bhadkamkar9snehil/Sofpad/_to_delete/r3_straight/render_rear_ports.png

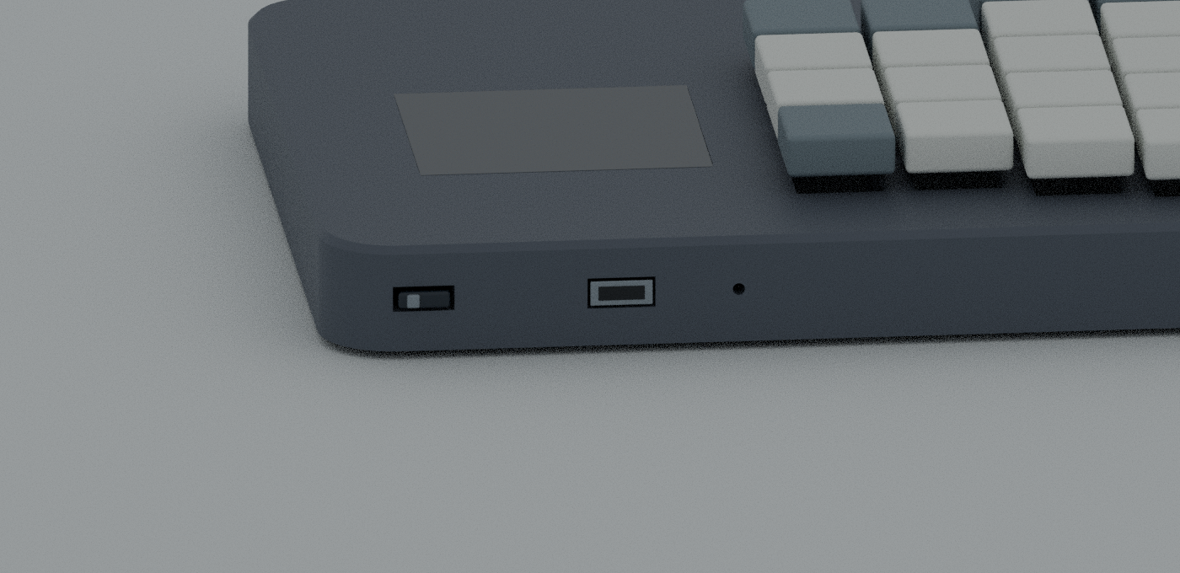
_to_delete/r3_straight/render_rear_ports.png
