bhadkamkar9snehil/Sofpad/_to_delete/r3_straight/render_service.png

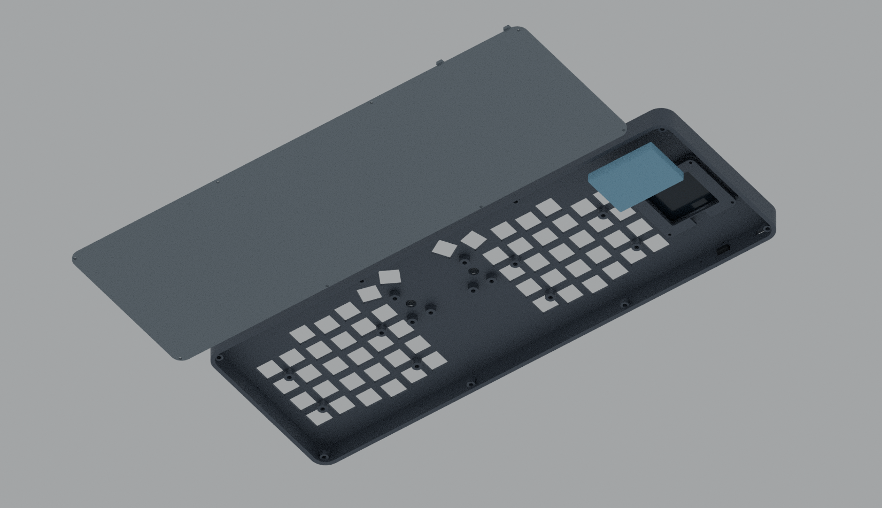
_to_delete/r3_straight/render_service.png
