bhadkamkar9snehil/Sofpad/_to_delete/sofle_couch/CAD_layout.png

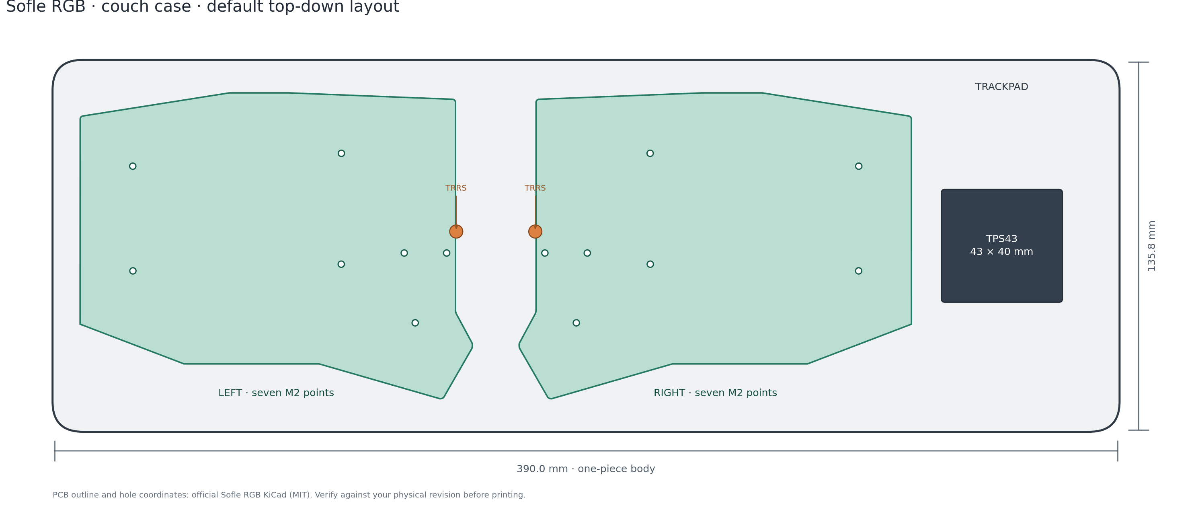
_to_delete/sofle_couch/CAD_layout.png
