bhadkamkar9snehil/Sofpad/_to_delete/sofle_unibody_v2/render_hero.png

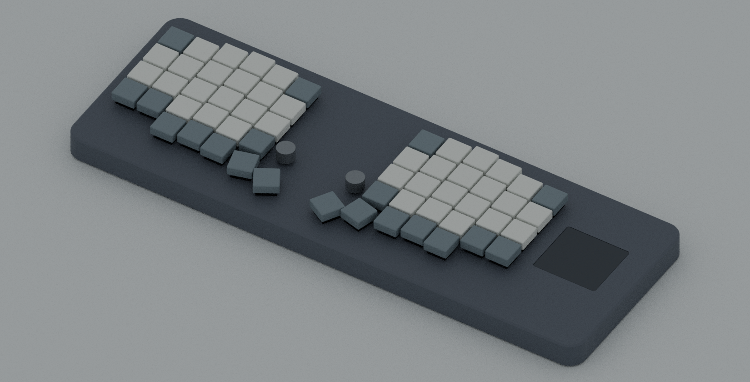
_to_delete/sofle_unibody_v2/render_hero.png
