bhadkamkar9snehil/Sofpad/_to_delete/sofle_unibody_v2/render_top.png

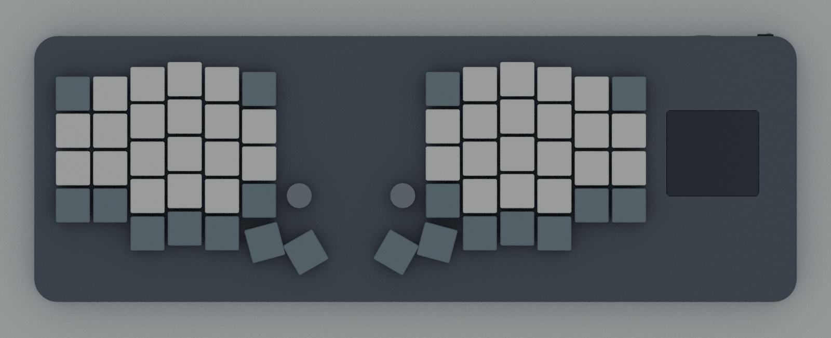
_to_delete/sofle_unibody_v2/render_top.png
