bhadkamkar9snehil/Sofpad/docs/images/sofpad-r2-gallery.webp

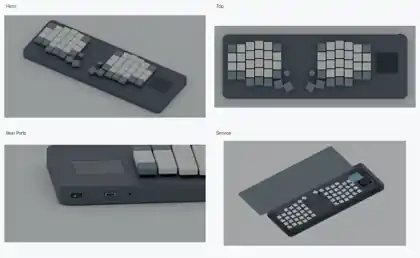
docs/images/sofpad-r2-gallery.webp
