bhadkamkar9snehil/Sofpad/docs/images/sofpad-r3-bay.png

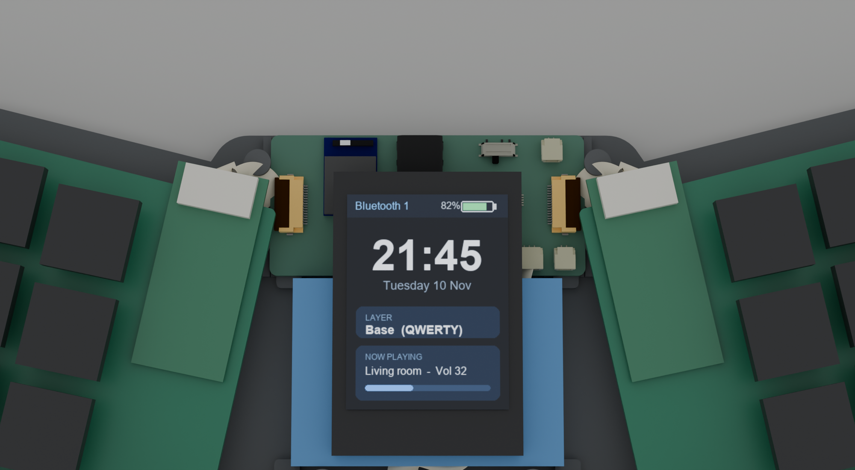
docs/images/sofpad-r3-bay.png
