bhadkamkar9snehil/Sofpad/docs/images/sofpad-r3-ghost.png

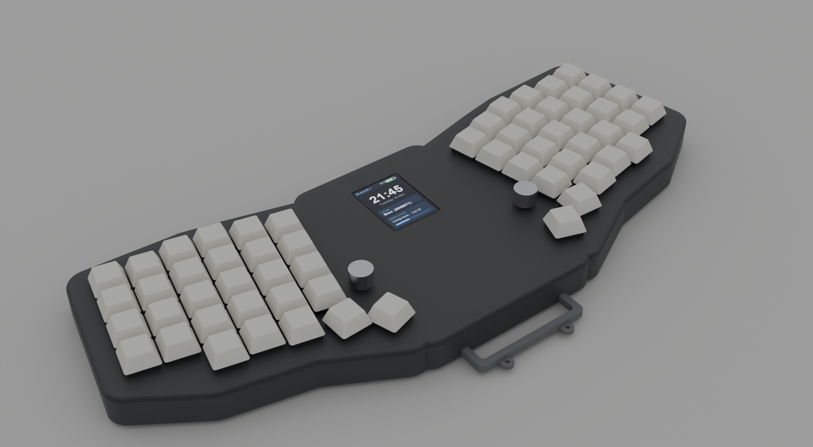
docs/images/sofpad-r3-ghost.png
