bhadkamkar9snehil/Sofpad/docs/images/sofpad-r3-internals-3q.png

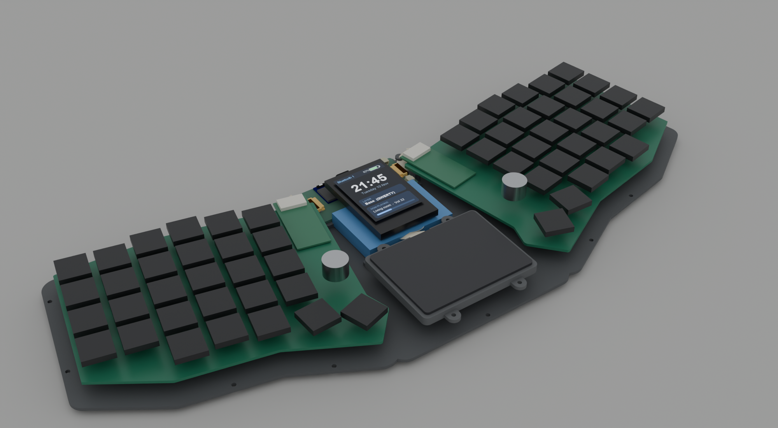
docs/images/sofpad-r3-internals-3q.png
