bhadkamkar9snehil/Sofpad/hardware/r3/pcb/carrier/bottom.png

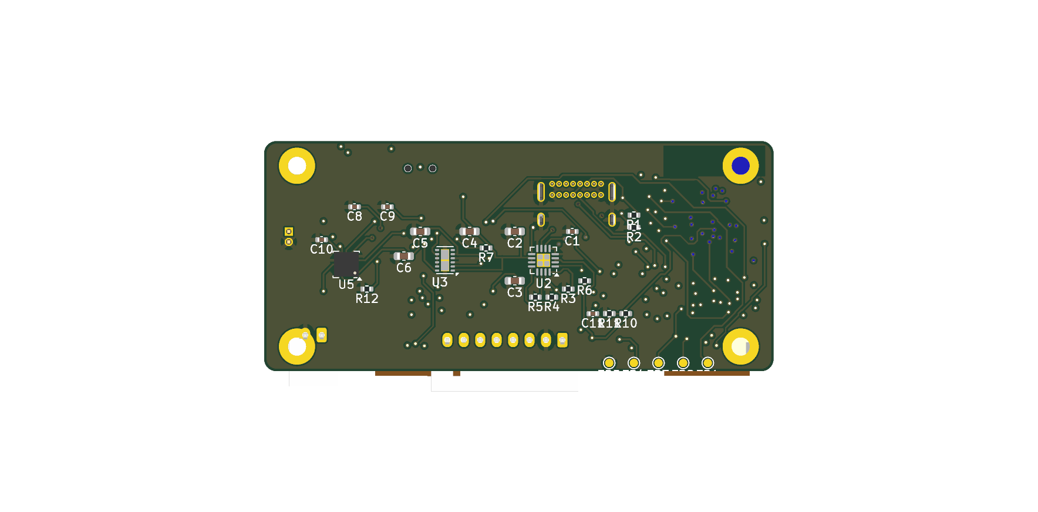
hardware/r3/pcb/carrier/bottom.png
