bhadkamkar9snehil/Sofpad/hardware/r3/pcb/carrier/top.png

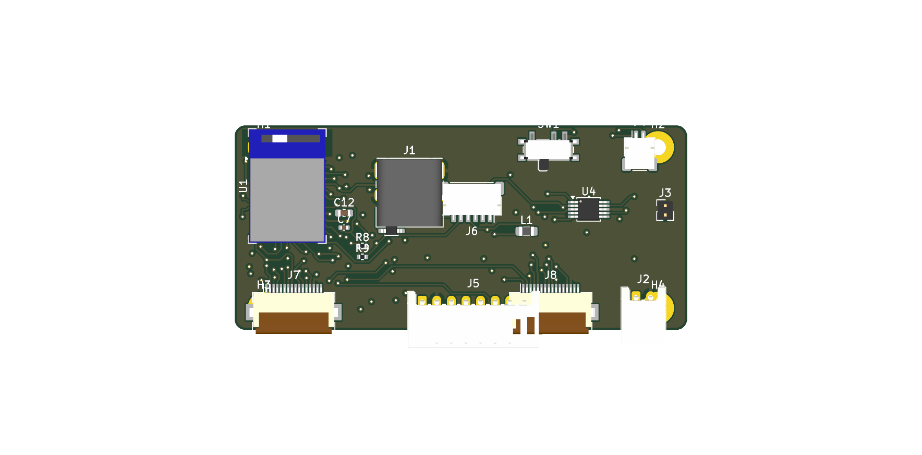
hardware/r3/pcb/carrier/top.png
