bhadkamkar9snehil/Sofpad/hardware/r3/pcb/fab/carrier/carrier-bom.csv

Comment | Designator | Footprint | Quantity
100k | R7 | R_0402_1005Metric | 1
100nF | C10,C11,C7 | C_0402_1005Metric | 3
10k | R12 | R_0402_1005Metric | 1
10uF | C12,C2,C3,C5,C6 | C_0603_1608Metric | 5
1M | R10,R11 | R_0402_1005Metric | 2
1uF | C1,C8,C9 | C_0402_1005Metric | 3
2.0k | R3 | R_0402_1005Metric | 1
2.2uH | L1 | L_0805_2012Metric | 1
3.0k | R6 | R_0402_1005Metric | 1
3.3k | R4 | R_0402_1005Metric | 1
3V3 | TP4 | TestPoint_Pad_D1.0mm | 1
4.7k | R8,R9 | R_0402_1005Metric | 2
4.7uF | C4 | C_0603_1608Metric | 1
470k | R13,R14,R15,R16 | R_0402_1005Metric | 4
47k | R5 | R_0402_1005Metric | 1
5.1k | R1,R2 | R_0402_1005Metric | 2
BQ24074RGTR | U2 | VQFN-16-1EP_3x3mm_P0.5mm_EP1.6x1.6mm | 1
Battery S2B-PH-SM4-TB | J2 | JST_PH_S2B-PH-SM4-TB_1x02-1MP_P2.00mm_Horizontal | 1
C&K PCM12SMTR | SW1 | SW_SPDT_PCM12 | 1
Cell NTC SM02B-SRSS-TB | J3 | JST_SH_SM02B-SRSS-TB_1x02-1MP_P1.00mm_Horizontal | 1
DRV2605LDGSR | U4 | MSOP-10_3x3mm_P0.5mm | 1
GCT USB4085-GF-A | J1 | USB_C_Receptacle_GCT_USB4085 | 1
GND | TP5 | TestPoint_Pad_D1.0mm | 1
LIS3DHTR | U5 | LGA-16_3x3mm_P0.5mm_LayoutBorder3x5y | 1
LRA SM02B-SRSS-TB | J4 | JST_SH_SM02B-SRSS-TB_1x02-1MP_P1.00mm_Horizontal | 1
Left FFC FH12-16S-0.5SH | J7 | Hirose_FH12-16S-0.5SH_1x16-1MP_P0.50mm_Horizontal | 1
MDBT50Q-1MV2 | U1 | Raytac_MDBT50Q | 1
RESET | TP3 | TestPoint_Pad_D1.0mm | 1
Right FFC FH12-16S-0.5SH | J8 | Hirose_FH12-16S-0.5SH_1x16-1MP_P0.50mm_Horizontal | 1
SWDCLK | TP2 | TestPoint_Pad_D1.0mm | 1
SWDIO | TP1 | TestPoint_Pad_D1.0mm | 1
Screen S8B-PH-SM4-TB | J5 | JST_PH_S8B-PH-SM4-TB_1x08-1MP_P2.00mm_Horizontal | 1
TPS62740DSST | U3 | WSON-12-1EP_3x2mm_P0.5mm_EP1x2.65 | 1
TPS65 breakout SM06B-SRSS-TB | J6 | JST_SH_SM06B-SRSS-TB_1x06-1MP_P1.00mm_Horizontal | 1
USBLC6-2SC6 | U6 | SOT-23-6 | 1
