bhadkamkar9snehil/Sofpad/_to_delete/r3_straight/TPS43_Retainer.stl

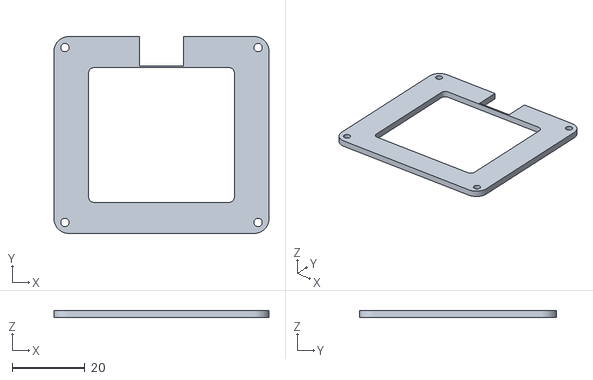
[picture p18: CAD file, 2026-11-09]
_to_delete/r3_straight/TPS43_Retainer.stl
59.0 x 54.0 x 2.00
