bhadkamkar9snehil/Sofpad/_to_delete/sofle_couch/SofleRGB_Couch_Case.stl

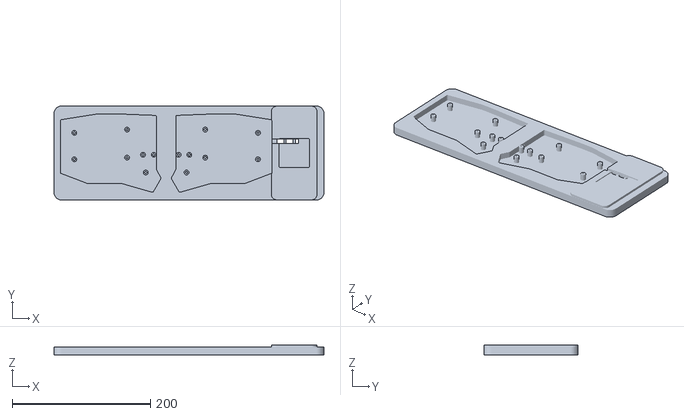
[picture p19: CAD file, 2026-11-09]
_to_delete/sofle_couch/SofleRGB_Couch_Case.stl
390.0 x 135.8 x 15.0
