bhadkamkar9snehil/Sofpad/_to_delete/sofle_unibody_v2/Unibody_Shell.stl

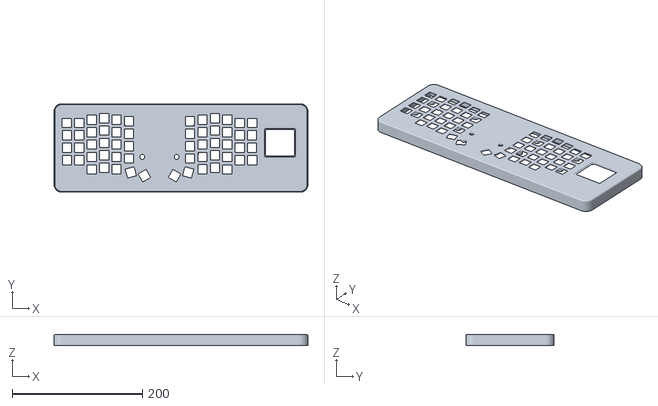
[picture p20: CAD file, 2026-11-09]
_to_delete/sofle_unibody_v2/Unibody_Shell.stl
390.0 x 135.8 x 17.5
