bhadkamkar9snehil/Sofpad/cad/r3/build/bottom.stl

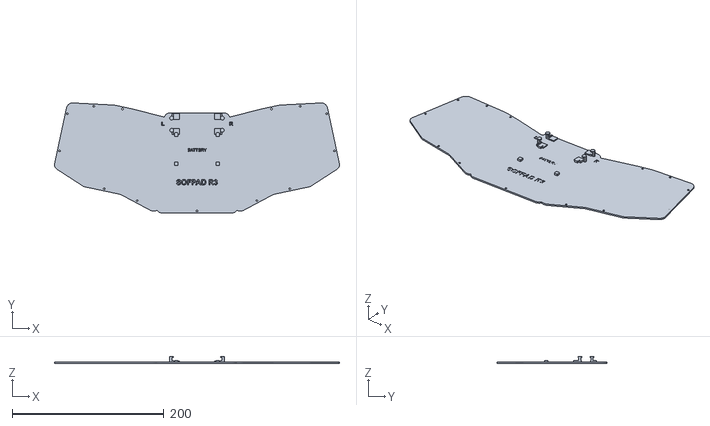
[picture p21: CAD file, 2026-11-09]
cad/r3/build/bottom.stl
375.7 x 145.2 x 9.00
