bhadkamkar9snehil/Sofpad/_to_delete/sofle_couch/TPS43_Fit_Coupon.stl

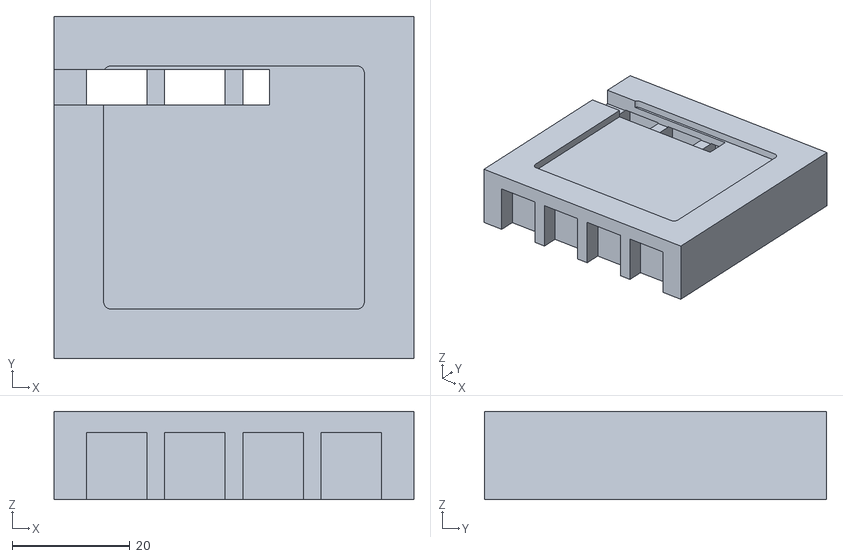
[picture p22: CAD file, 2026-11-09]
_to_delete/sofle_couch/TPS43_Fit_Coupon.stl
61.0 x 58.0 x 15.0
