bhadkamkar9snehil/Sofpad/_to_delete/sofle_unibody_v2/Service_Bottom.stl

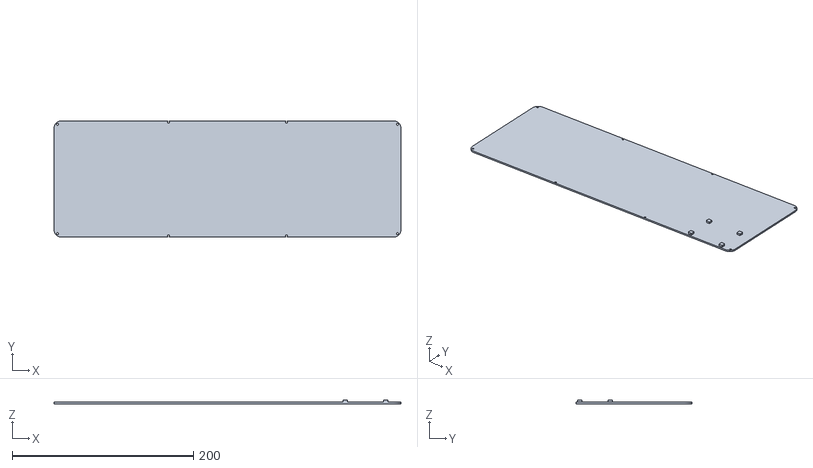
[picture p23: CAD file, 2026-11-09]
_to_delete/sofle_unibody_v2/Service_Bottom.stl
382.5 x 128.3 x 4.00
