bhadkamkar9snehil/Sofpad/cad/r3/build/shell.stl

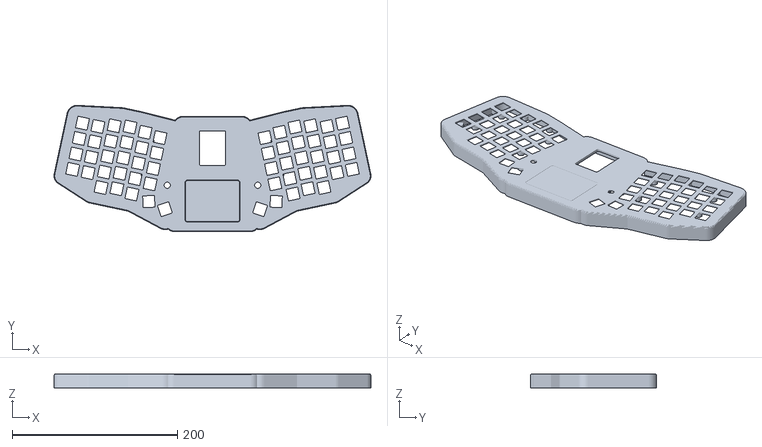
[picture p24: CAD file, 2026-11-09]
cad/r3/build/shell.stl
383.2 x 152.7 x 17.1
