bhadkamkar9snehil/Sofpad/_to_delete/sofle_single_controller_orig/cad/Cirque40_Retainer.stl

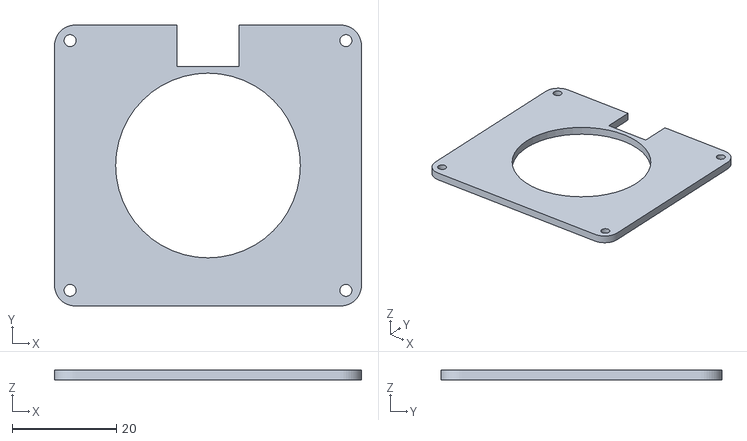
[picture p25: CAD file, 2026-11-09]
_to_delete/sofle_single_controller_orig/cad/Cirque40_Retainer.stl
59.0 x 54.0 x 2.00
