bhadkamkar9snehil/Sofpad/cad/r3/build/padbody.stl

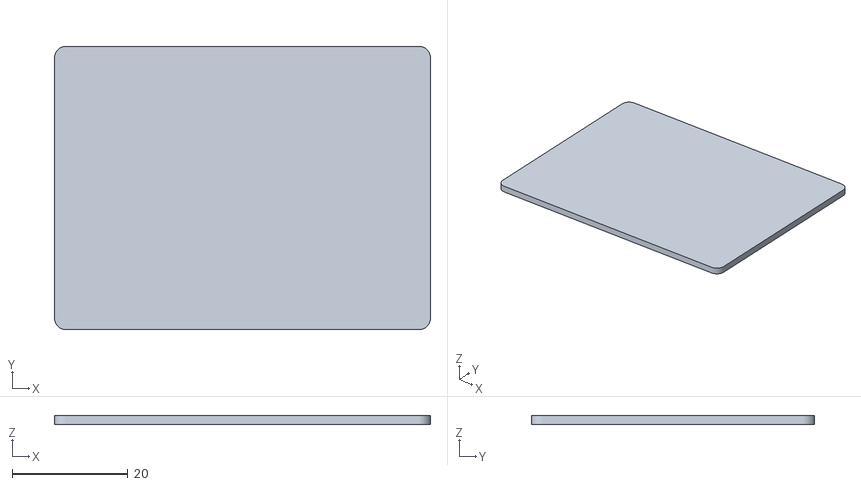
[picture p26: CAD file, 2026-11-09]
cad/r3/build/padbody.stl
65.0 x 49.0 x 1.53
