bhadkamkar9snehil/Sofpad/cad/r3/build/padface.stl

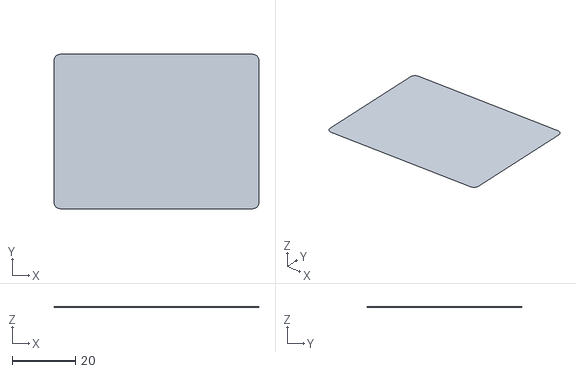
[picture p27: CAD file, 2026-11-09]
cad/r3/build/padface.stl
65.0 x 49.0 x 0.08
