bhadkamkar9snehil/Sofpad/cad/r3/build/adapters.stl

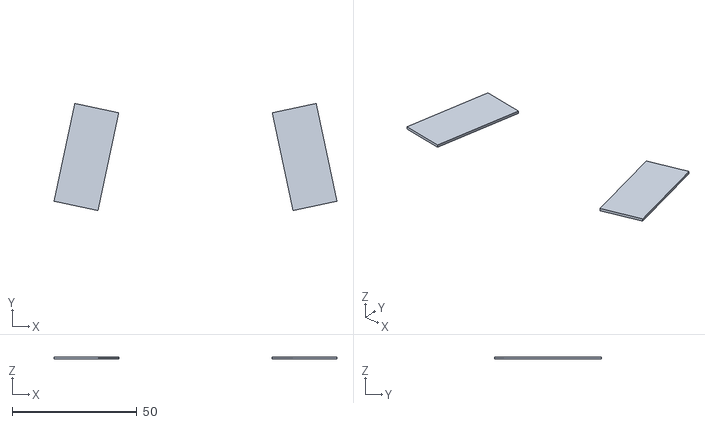
[picture p28: CAD file, 2026-11-09]
cad/r3/build/adapters.stl
113.3 x 42.9 x 1.00
