bhadkamkar9snehil/Sofpad/cad/r3/build/battery.stl

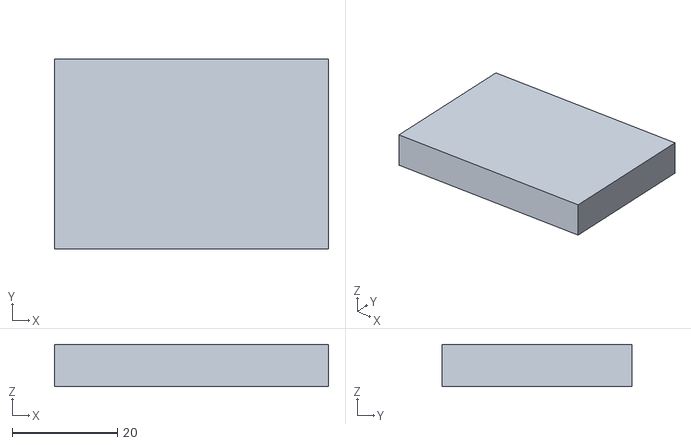
[picture p29: CAD file, 2026-11-09]
cad/r3/build/battery.stl
52.0 x 36.0 x 8.00
