bhadkamkar9snehil/Sofpad/cad/r3/build/carrier.stl

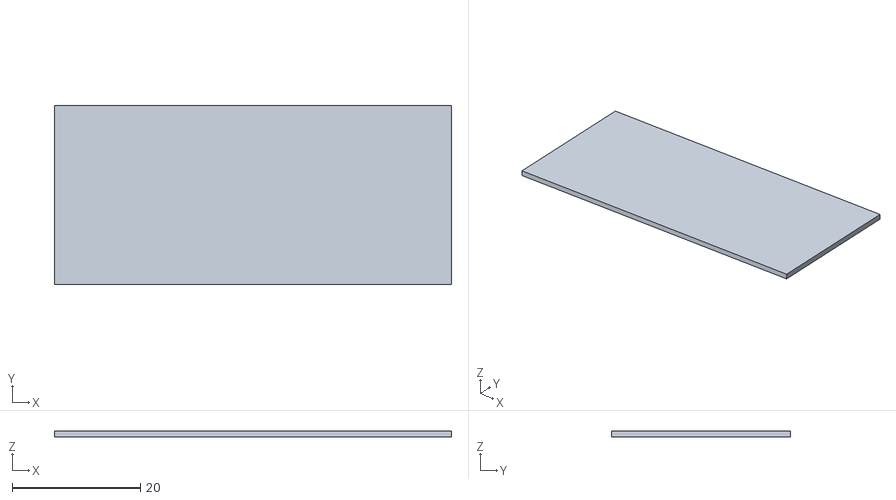
[picture p30: CAD file, 2026-11-09]
cad/r3/build/carrier.stl
62.0 x 28.0 x 1.00
