bhadkamkar9snehil/Sofpad/cad/r3/build/retainer_view.stl

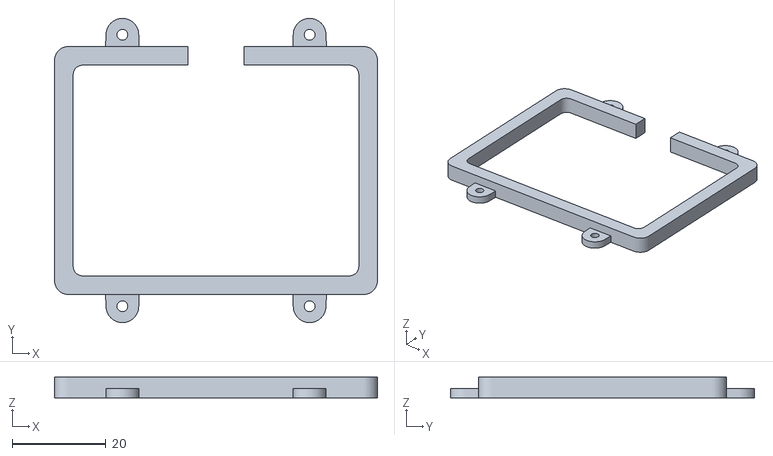
[picture p31: CAD file, 2026-11-09]
cad/r3/build/retainer_view.stl
69.0 x 65.0 x 4.47
