bhadkamkar9snehil/Sofpad/cad/r3/build/adapter_conns.stl

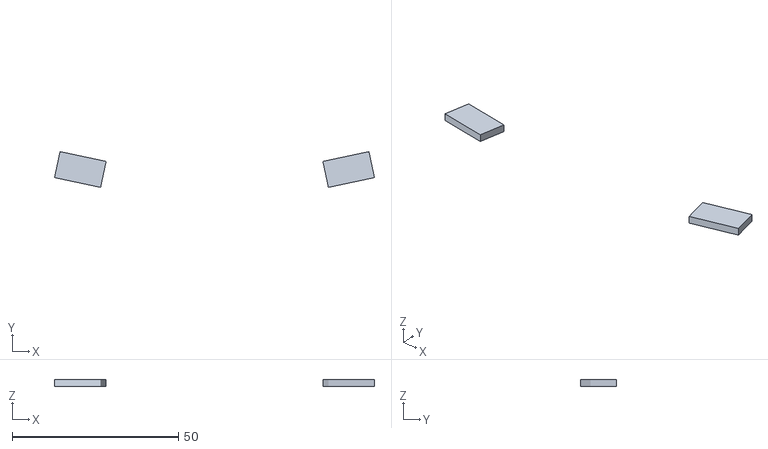
[picture p32: CAD file, 2026-11-09]
cad/r3/build/adapter_conns.stl
96.4 x 10.8 x 2.00
