bhadkamkar9snehil/Sofpad/cad/r3/build/screen.stl

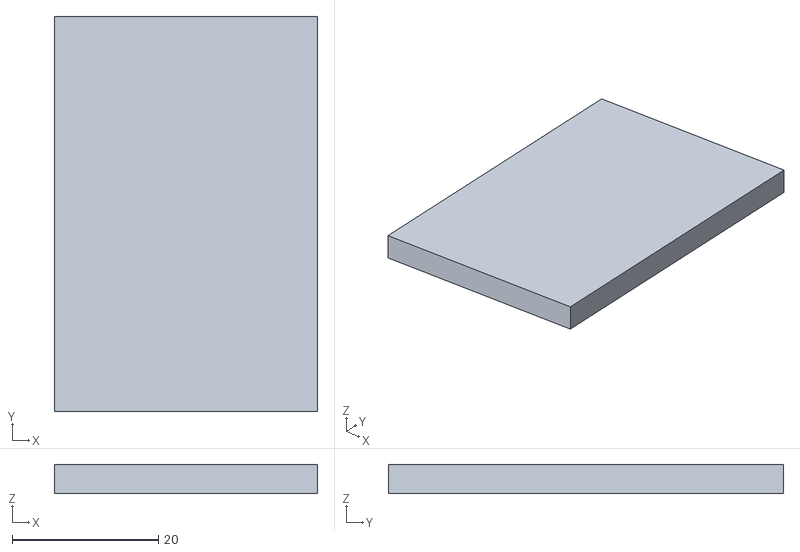
[picture p33: CAD file, 2026-11-09]
cad/r3/build/screen.stl
36.0 x 54.0 x 4.00
