bhadkamkar9snehil/Sofpad/cad/r3/build/keys.stl

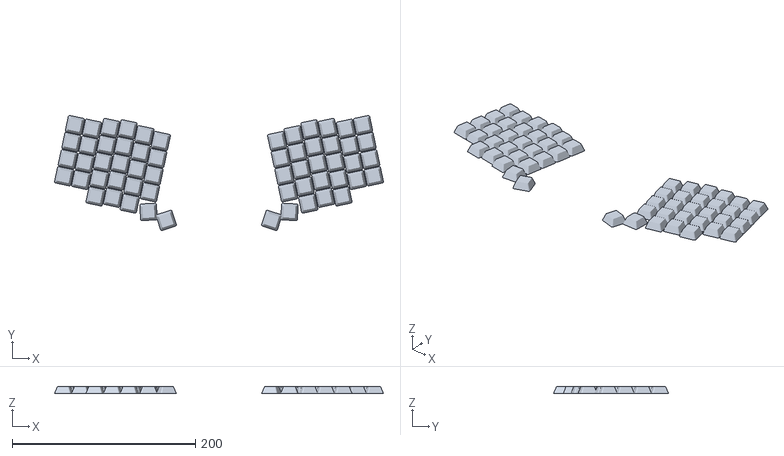
[picture p34: CAD file, 2026-11-09]
cad/r3/build/keys.stl
359.1 x 125.6 x 7.40
