bhadkamkar9snehil/Sofpad/cad/r3/build/knobs.stl

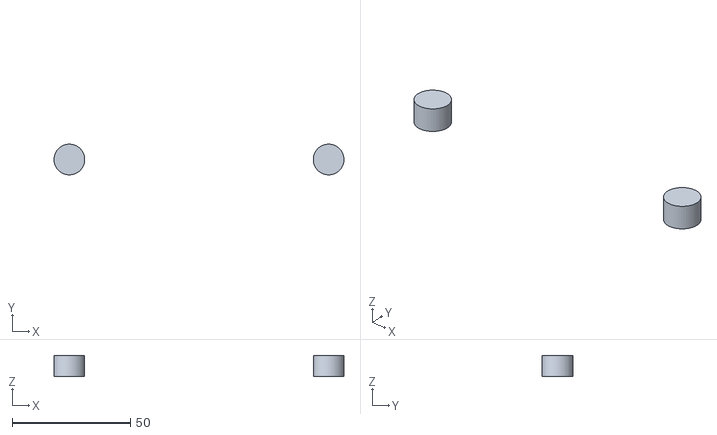
[picture p35: CAD file, 2026-11-09]
cad/r3/build/knobs.stl
122.5 x 13.0 x 9.00
