bhadkamkar9snehil/Sofpad/cad/r3/build/switches.stl

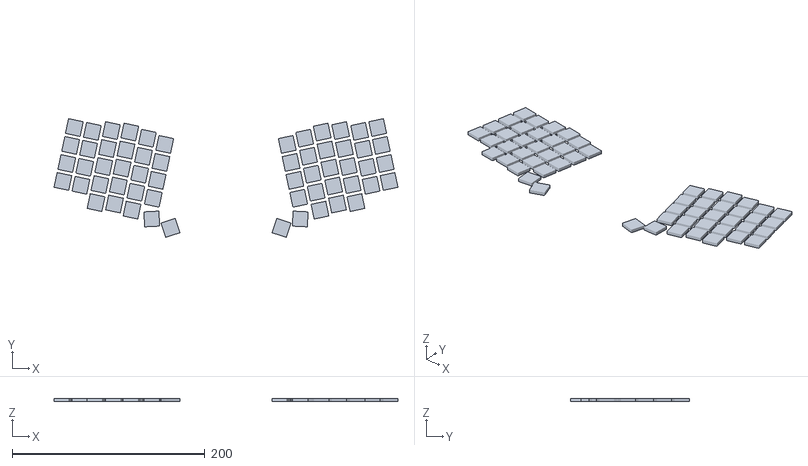
[picture p36: CAD file, 2026-11-09]
cad/r3/build/switches.stl
356.5 x 123.1 x 3.30
