bhadkamkar9snehil/Sofpad/cad/r3/build/pcbs.stl

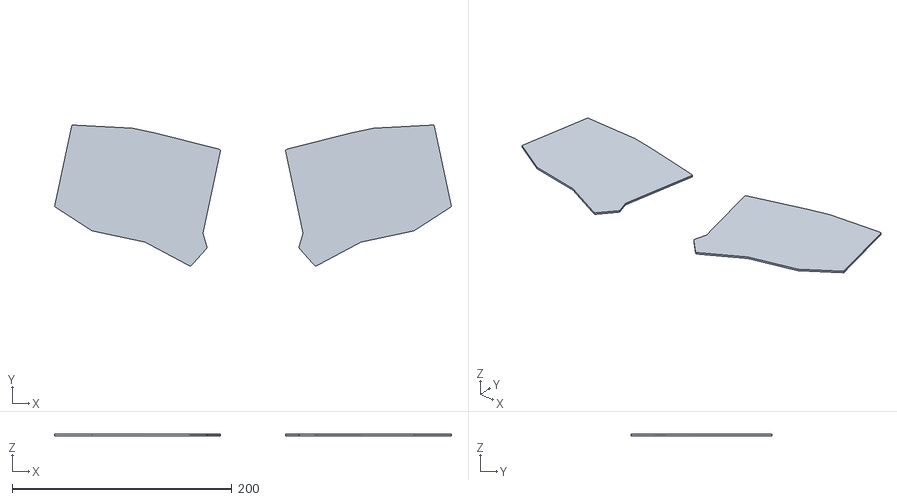
[picture p37: CAD file, 2026-11-09]
cad/r3/build/pcbs.stl
361.2 x 128.2 x 1.60
