bhadkamkar9snehil/Sofpad/_to_delete/sofle_couch/sofle_rgb_geometry.scad

// Generated from Sofle RGB PCB by extract_sofle_geometry.py.
// Source: https://github.com/josefadamcik/SofleKeyboard
// Git commit: fb294f7c58d0f91c379a9ef339159d4d056643e9
// The source project is MIT licensed; see LICENSE-SOFLE.txt.
// Units: mm. Origin: board bounding box, lower-left in the OpenSCAD view.
// The RIGHT half uses this outline. The LEFT half is mirrored in X.

board_w = 143.4952;
board_h = 111.8500;
board_outline = [
    [142.4254, 103.3549],
    [142.6271, 103.3032],
    [142.8119, 103.2185],
    [142.9766, 103.1044],
    [143.1183, 102.9644],
    [143.2339, 102.8022],
    [143.3203, 102.6213],
    [143.3744, 102.4254],
    [143.3932, 102.2181],
    [143.4202, 27.3000],
    [105.4500, 12.8000],
    [56.1041, 12.8000],
    [11.8500, 0.0500],
    [11.3000, 0.1500],
    [10.8500, 0.3000],
    [10.5000, 0.6000],
    [0.2500, 18.4000],
    [0.1000, 18.9000],
    [0.0500, 19.5000],
    [0.0500, 19.9000],
    [0.1500, 20.4000],
    [5.9500, 31.1500],
    [6.1500, 31.7500],
    [6.2253, 32.4000],
    [6.2239, 108.3226],
    [6.2473, 108.5547],
    [6.3144, 108.7710],
    [6.4206, 108.9667],
    [6.5613, 109.1372],
    [6.7318, 109.2778],
    [6.9274, 109.3841],
    [7.1437, 109.4512],
    [7.3759, 109.4746],
    [66.9500, 111.8000],
    [88.9000, 111.8000]
];
board_mount_holes = [
    [9.4500, 53.3000],
    [24.9500, 53.3000],
    [47.9250, 89.7250],
    [124.1750, 85.0250],
    [47.9750, 49.2250],
    [124.1250, 46.7750],
    [20.9500, 27.8000]
];
board_trrs = [5.9500, 61.1500];
