bhadkamkar9snehil/Sofpad/_to_delete/sofle_unibody_v2/sofle_components.scad

// Positions copied from the official Sofle RGB KiCad PCB (MIT).
// x/y are board-local mm. Angle is corrected for a Y-up view.
key_positions = [
    [38.45, 96.8, -180.0],
    [57.45, 99.3, -180.0],
    [76.55, 101.8, -180.0],
    [95.55, 99.3, -180.0],
    [114.65, 94.4, -180.0],
    [133.75, 94.4, -180.0],
    [38.45, 77.7, -180.0],
    [57.45, 80.2, -180.0],
    [76.55, 82.71, -180.0],
    [95.55, 80.3, -180.0],
    [114.65, 75.5, -180.0],
    [133.65, 75.5, -180.0],
    [38.45, 58.7, -180.0],
    [57.45, 61.2, -180.0],
    [76.55, 63.61, -180.0],
    [95.55, 61.2, -180.0],
    [114.65, 56.3, -180.0],
    [133.65, 56.3, -180.0],
    [38.45, 39.7, -180.0],
    [57.45, 42.1, -180.0],
    [76.55, 44.61, -180.0],
    [95.55, 42.1, -180.0],
    [114.65, 37.3, -180.0],
    [133.7, 37.3, -180.0],
    [14.66, 13.4, -120.0],
    [35.55, 18.4, 165.0],
    [57.45, 23.1, -180.0],
    [76.55, 25.51, -180.0],
    [95.55, 23.0, -180.0]
];
encoder_positions = [
    [17.95, 42.3, -0.0]
];
