bhadkamkar9snehil/Sofpad/(list of files, cad)

Other CAD files:
_to_delete/r3_straight/Unibody_Shell.stl
_to_delete/r3_straight/Service_Bottom.stl
_to_delete/sofle_unibody_v2/TPS43_Retainer.stl
cad/r3/build/retainer.stl
_to_delete/sofle_unibody_v2/SofleRGB_Unibody_Couch.scad
_to_delete/sofle_single_controller_orig/cad/Service_Bottom.stl
_to_delete/sofle_single_controller_orig/cad/SofleRGB_SingleController_Cirque.scad
_to_delete/sofle_single_controller_orig/cad/Unibody_Shell.stl
