bhadkamkar9snehil/Sofpad/cad/r3/build/screen_ui.png

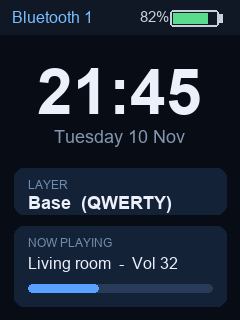
cad/r3/build/screen_ui.png
