bhadkamkar9snehil/Sofpad/(list of files, drawings)

Other design files:
hardware/r3/pcb/adapter/adapter_a.dsn
hardware/r3/pcb/adapter/adapter_b.dsn
hardware/r3/pcb/carrier/carrier.dsn
