bhadkamkar9snehil/Sofpad/hardware/r3/pcb/carrier/carrier.kicad_pcb

## KiCad design hardware/r3/pcb/carrier/carrier.kicad_pcb (2026-11-10)

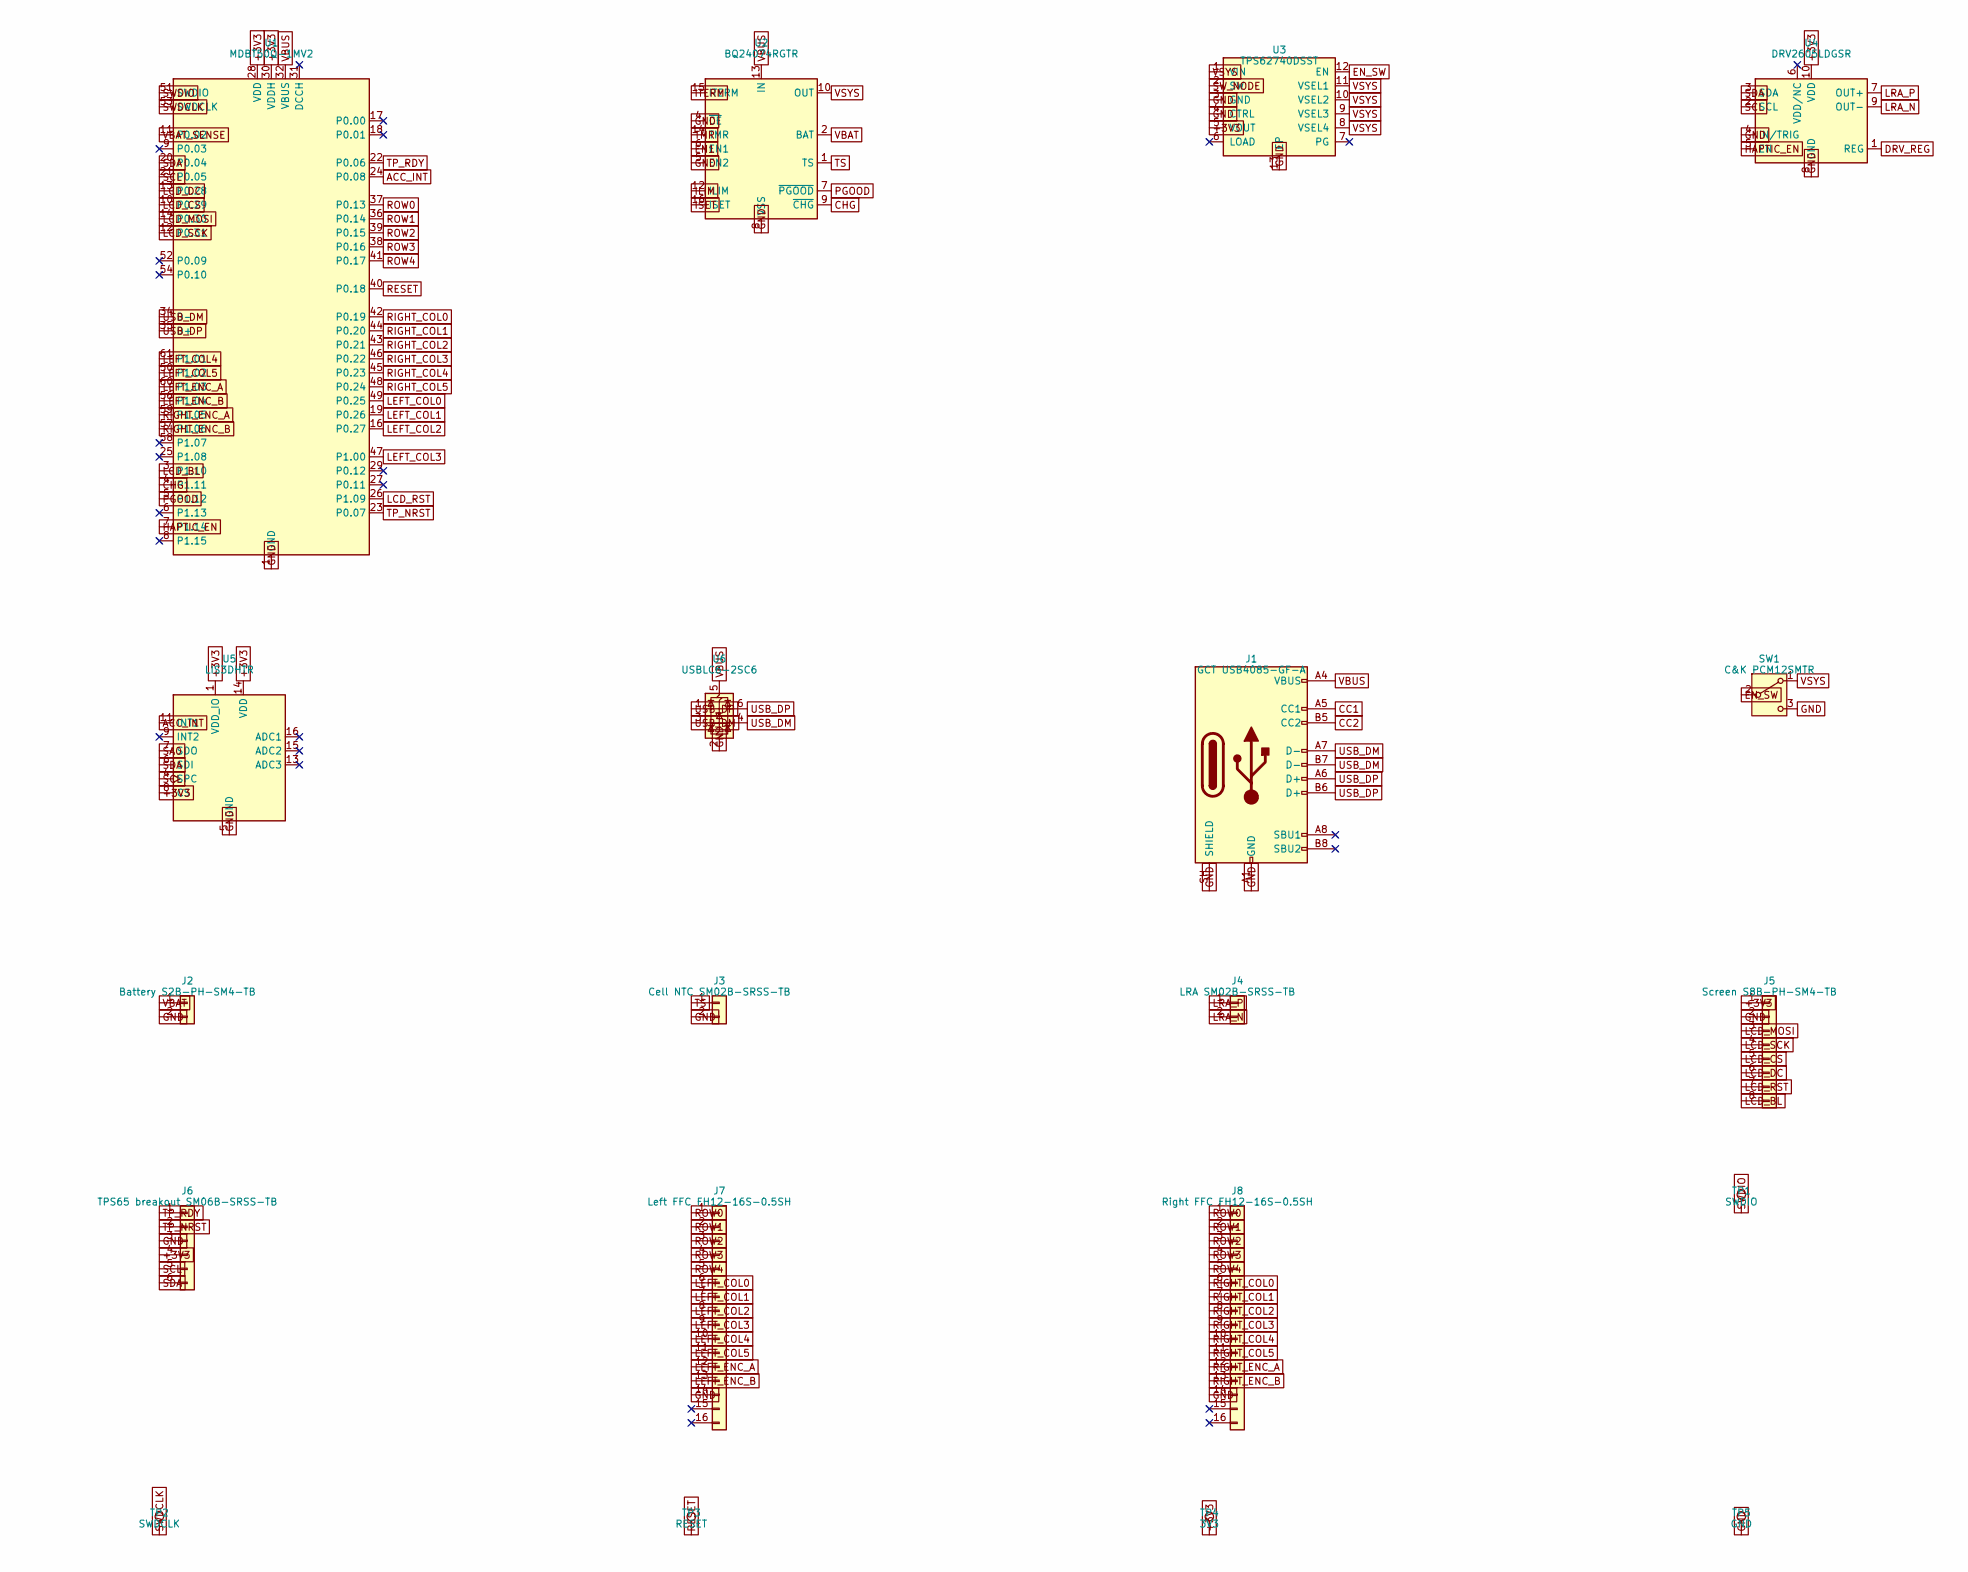
[picture p39: schematic carrier.kicad_sch, part in row 1, column 1]

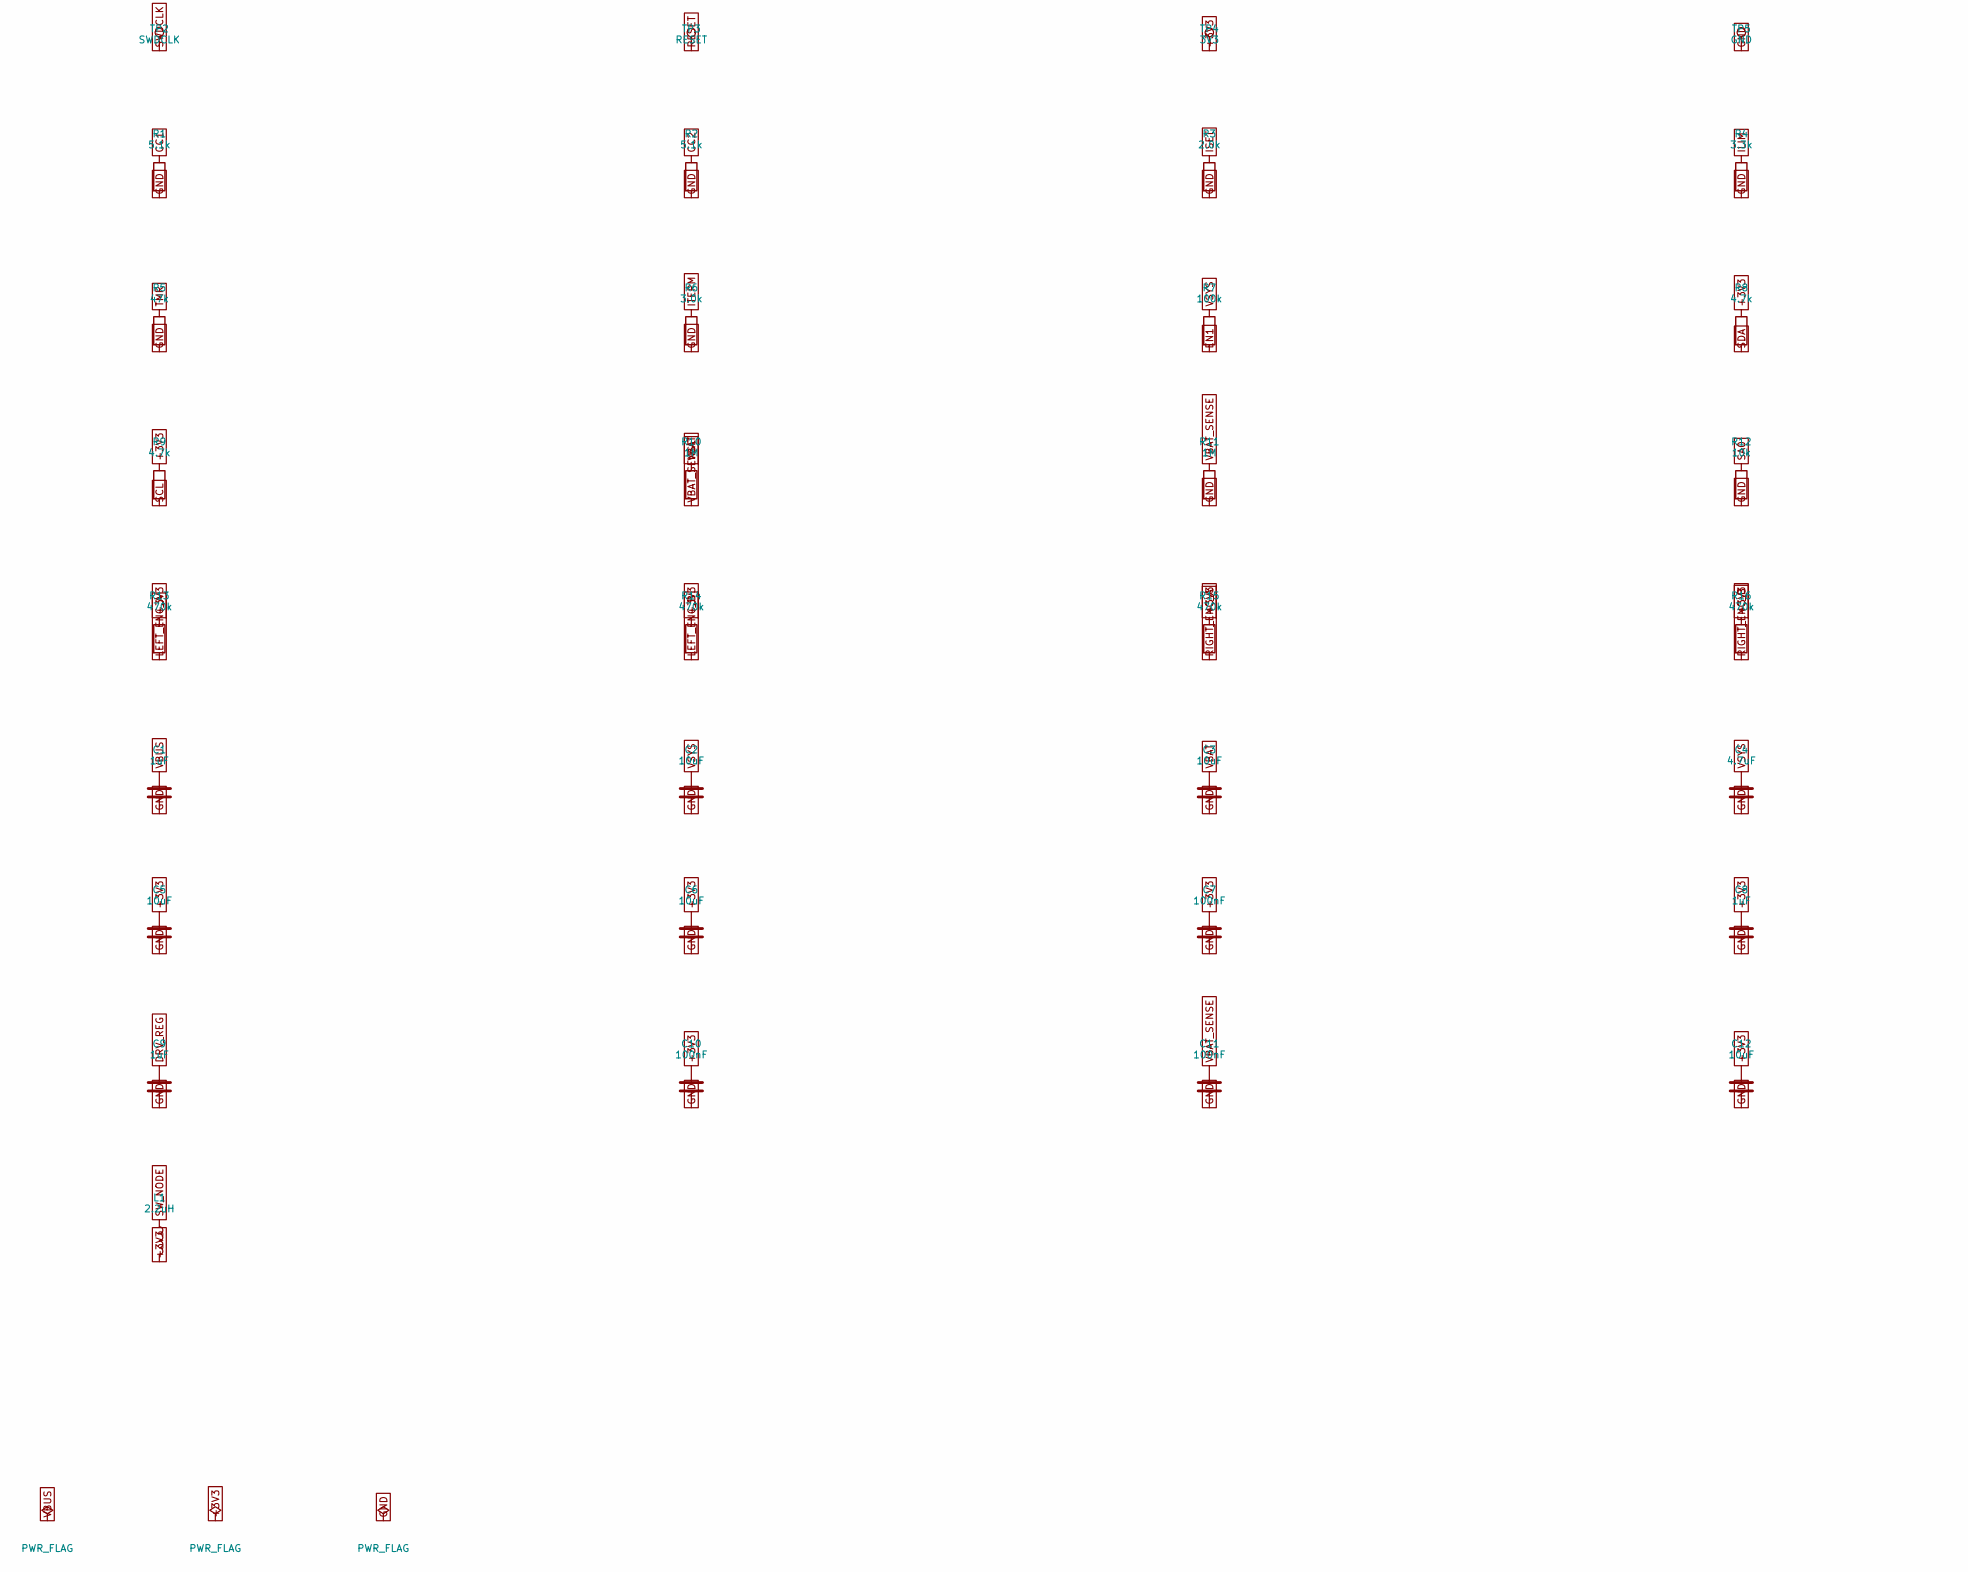
[picture p40: schematic carrier.kicad_sch, part in row 2, column 1]

Parts:
C1, C8, C9: 1uF; C_0402_1005Metric
C2, C3, C5, C6, C12: 10uF; C_0603_1608Metric
C4: 4.7uF; C_0603_1608Metric
C7, C10, C11: 100nF; C_0402_1005Metric
J1: GCT USB4085-GF-A; USB_C_Receptacle_GCT_USB4085
J2: Battery S2B-PH-SM4-TB; JST_PH_S2B-PH-SM4-TB_1x02-1MP_P2.00mm_Horizontal
J3: Cell NTC SM02B-SRSS-TB; JST_SH_SM02B-SRSS-TB_1x02-1MP_P1.00mm_Horizontal
J4: LRA SM02B-SRSS-TB; JST_SH_SM02B-SRSS-TB_1x02-1MP_P1.00mm_Horizontal
J5: Screen S8B-PH-SM4-TB; JST_PH_S8B-PH-SM4-TB_1x08-1MP_P2.00mm_Horizontal
J6: TPS65 breakout SM06B-SRSS-TB; JST_SH_SM06B-SRSS-TB_1x06-1MP_P1.00mm_Horizontal
J7: Left FFC FH12-16S-0.5SH; Hirose_FH12-16S-0.5SH_1x16-1MP_P0.50mm_Horizontal
J8: Right FFC FH12-16S-0.5SH; Hirose_FH12-16S-0.5SH_1x16-1MP_P0.50mm_Horizontal
L1: 2.2uH; L_0805_2012Metric
R1, R2: 5.1k; R_0402_1005Metric
R3: 2.0k; R_0402_1005Metric
R4: 3.3k; R_0402_1005Metric
R5: 47k; R_0402_1005Metric
R6: 3.0k; R_0402_1005Metric
R7: 100k; R_0402_1005Metric
R8, R9: 4.7k; R_0402_1005Metric
R10, R11: 1M; R_0402_1005Metric
R12: 10k; R_0402_1005Metric
R13, R14, R15, R16: 470k; R_0402_1005Metric
SW1: C&K PCM12SMTR; SW_SPDT_PCM12
TP1: SWDIO; TestPoint_Pad_D1.0mm
TP2: SWDCLK; TestPoint_Pad_D1.0mm
TP3: RESET; TestPoint_Pad_D1.0mm
TP4: 3V3; TestPoint_Pad_D1.0mm
TP5: GND; TestPoint_Pad_D1.0mm
U1: MDBT50Q-1MV2; Raytac_MDBT50Q
U2: BQ24074RGTR; VQFN-16-1EP_3x3mm_P0.5mm_EP1.6x1.6mm
U3: TPS62740DSST; WSON-12-1EP_3x2mm_P0.5mm_EP1x2.65
U4: DRV2605LDGSR; MSOP-10_3x3mm_P0.5mm
U5: LIS3DHTR; LGA-16_3x3mm_P0.5mm_LayoutBorder3x5y
U6: USBLC6-2SC6; SOT-23-6

Connections:
+3V3: C5.1, C6.1, C7.1, C8.1, C10.1, C12.1, J5.1, J6.4, L1.2, R8.1, R9.1, R13.1, R14.1, R15.1, R16.1, TP4.1, U1.28 (VDD), U1.30 (VDDH), U3.5 (VOUT), U4.10 (VDD), U5.1 (VDD_IO), U5.8 (CS), U5.14 (VDD)
ACC_INT: U1.24 (P0.08), U5.11 (INT1)
CC1: J1.A5 (CC1), R1.1
CC2: J1.B5 (CC2), R2.1
CHG: U1.4 (P1.11), U2.9 (~CHG)
DRV_REG: C9.1, U4.1 (REG)
EN1: R7.2, U2.6 (EN1)
EN_SW: SW1.2 (B), U3.12 (EN)
GND: C1.2, C2.2, C3.2, C4.2, C5.2, C6.2, C7.2, C8.2, C9.2, C10.2, C11.2, C12.2, J1.A1 (GND), J1.A12 (GND), J1.B1 (GND), J1.B12 (GND), J1.SH (SHIELD), J2.2, J3.2, J5.2, J6.3, J7.14, J8.14, R1.2, R2.2, R3.2, R4.2, R5.2, R6.2, R11.2, R12.2, SW1.3 (C), TP5.1, U1.1 (GND), U1.2 (GND), U1.15 (GND), U1.33 (GND), U1.55 (GND), U2.4 (~CE), U2.5 (EN2), U2.8 (VSS), U2.17 (VSS), U3.3 (GND), U3.4 (CTRL), U3.13 (EP), U4.4 (IN/TRIG), U4.8 (GND), U5.5 (GND), U5.10 (GND), U5.12 (GND), U6.2 (GND)
HAPTIC_EN: U1.7 (P1.14), U4.5 (EN)
ILIM: R4.1, U2.12 (ILIM)
ISET: R3.1, U2.16 (ISET)
ITERM: R6.1, U2.15 (ITERM)
LCD_BL: J5.8, U1.3 (P1.10)
LCD_CS: J5.5, U1.10 (P0.29)
LCD_DC: J5.6, U1.13 (P0.28)
LCD_MOSI: J5.3, U1.14 (P0.30)
LCD_RST: J5.7, U1.26 (P1.09)
LCD_SCK: J5.4, U1.12 (P0.31)
LEFT_COL0: J7.6, U1.49 (P0.25)
LEFT_COL1: J7.7, U1.19 (P0.26)
LEFT_COL2: J7.8, U1.16 (P0.27)
LEFT_COL3: J7.9, U1.47 (P1.00)
LEFT_COL4: J7.10, U1.61 (P1.01)
LEFT_COL5: J7.11, U1.50 (P1.02)
LEFT_ENC_A: J7.12, R13.2, U1.60 (P1.03)
LEFT_ENC_B: J7.13, R14.2, U1.56 (P1.04)
LRA_N: J4.2, U4.9 (OUT-)
LRA_P: J4.1, U4.7 (OUT+)
PGOOD: U1.5 (P1.12), U2.7 (~PGOOD)
RESET: TP3.1, U1.40 (P0.18)
RIGHT_COL0: J8.6, U1.42 (P0.19)
RIGHT_COL1: J8.7, U1.44 (P0.20)
RIGHT_COL2: J8.8, U1.43 (P0.21)
RIGHT_COL3: J8.9, U1.46 (P0.22)
RIGHT_COL4: J8.10, U1.45 (P0.23)
RIGHT_COL5: J8.11, U1.48 (P0.24)
RIGHT_ENC_A: J8.12, R15.2, U1.59 (P1.05)
RIGHT_ENC_B: J8.13, R16.2, U1.57 (P1.06)
ROW0: J7.1, J8.1, U1.37 (P0.13)
ROW1: J7.2, J8.2, U1.36 (P0.14)
ROW2: J7.3, J8.3, U1.39 (P0.15)
ROW3: J7.4, J8.4, U1.38 (P0.16)
ROW4: J7.5, J8.5, U1.41 (P0.17)
SA0: R12.1, U5.7 (SDO)
SCL: J6.5, R9.2, U1.21 (P0.05), U4.2 (SCL), U5.4 (SPC)
SDA: J6.6, R8.2, U1.20 (P0.04), U4.3 (SDA), U5.6 (SDI)
SWDCLK: TP2.1, U1.53 (SWDCLK)
SWDIO: TP1.1, U1.51 (SWDIO)
SW_NODE: L1.1, U3.2 (SW)
TMR: R5.1, U2.14 (TMR)
TP_NRST: J6.2, U1.23 (P0.07)
TP_RDY: J6.1, U1.22 (P0.06)
TS: J3.1, U2.1 (TS)
USB_DM: J1.A7 (D-), J1.B7 (D-), U1.34 (D-), U6.3 (I/O2), U6.4 (I/O2)
USB_DP: J1.A6 (D+), J1.B6 (D+), U1.35 (D+), U6.1 (I/O1), U6.6 (I/O1)
VBAT: C3.1, J2.1, R10.1, U2.2 (BAT), U2.3 (BAT)
VBAT_SENSE: C11.1, R10.2, R11.1, U1.11 (P0.02)
VBUS: C1.1, J1.A4 (VBUS), J1.A9 (VBUS), J1.B4 (VBUS), J1.B9 (VBUS), U1.32 (VBUS), U2.13 (IN), U6.5 (VBUS)
VSYS: C2.1, C4.1, R7.1, SW1.1 (A), U2.10 (OUT), U2.11 (OUT), U3.1 (VIN), U3.8 (VSEL4), U3.9 (VSEL3), U3.10 (VSEL2), U3.11 (VSEL1)

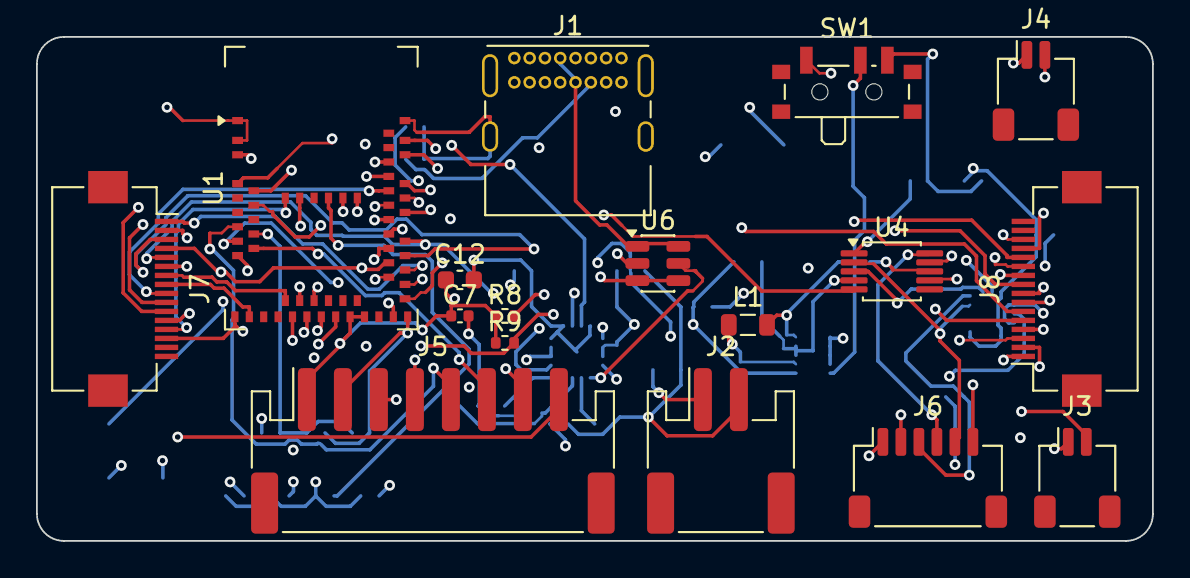
[picture p41: board carrier.kicad_pcb from above]

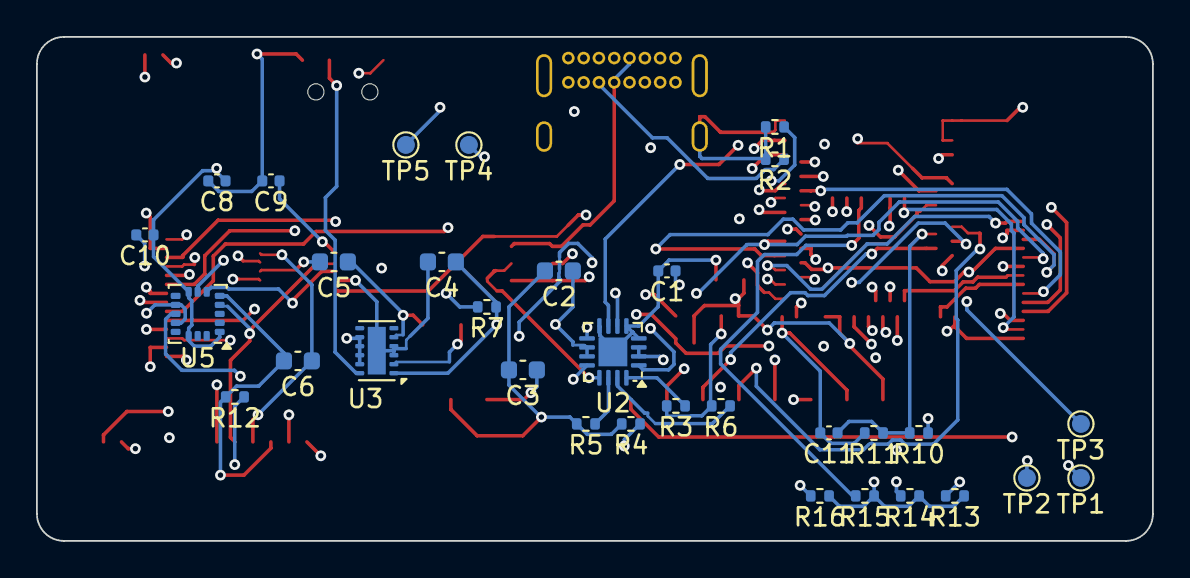
[picture p42: board carrier.kicad_pcb from below]

Board: 4 copper layers, 62.0 x 28.0 mm, 49 parts (32 on the bottom side), 60 nets.
