bhadkamkar9snehil/Sofpad/hardware/r3/pcb/adapter/adapter_a.kicad_pcb

## KiCad design hardware/r3/pcb/adapter/adapter_a.kicad_pcb (2026-11-10)

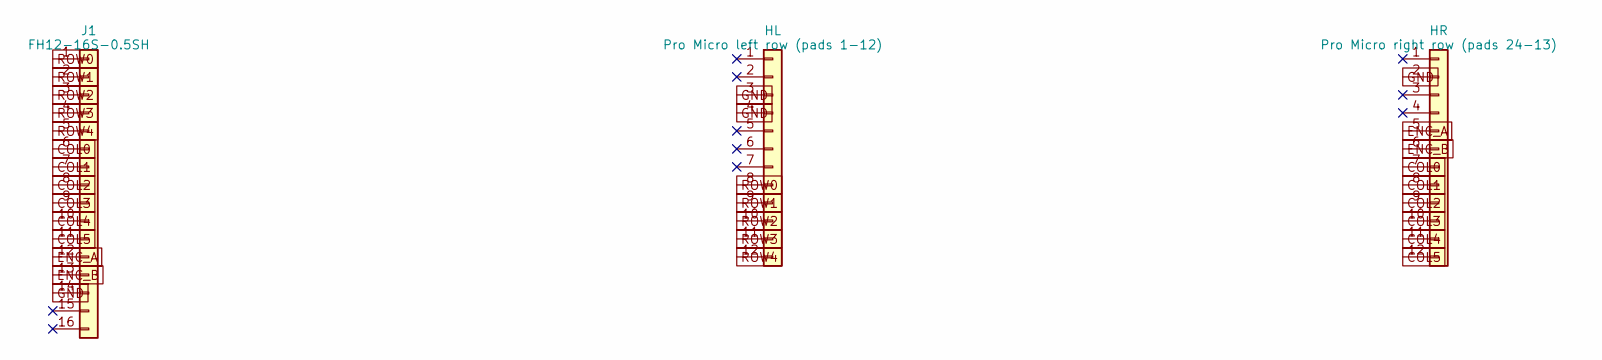
[picture p43: schematic adapter.kicad_sch]

Parts:
HL: Pro Micro left row (pads 1-12); PinHeader_1x12_P2.54mm_Vertical
HR: Pro Micro right row (pads 24-13); PinHeader_1x12_P2.54mm_Vertical
J1: FH12-16S-0.5SH; Hirose_FH12-16S-0.5SH_1x16-1MP_P0.50mm_Horizontal

Connections:
COL0: HR.7, J1.6
COL1: HR.8, J1.7
COL2: HR.9, J1.8
COL3: HR.10, J1.9
COL4: HR.11, J1.10
COL5: HR.12, J1.11
ENC_A: HR.5, J1.12
ENC_B: HR.6, J1.13
GND: HL.3, HL.4, HR.2, J1.14
ROW0: HL.8, J1.1
ROW1: HL.9, J1.2
ROW2: HL.10, J1.3
ROW3: HL.11, J1.4
ROW4: HL.12, J1.5

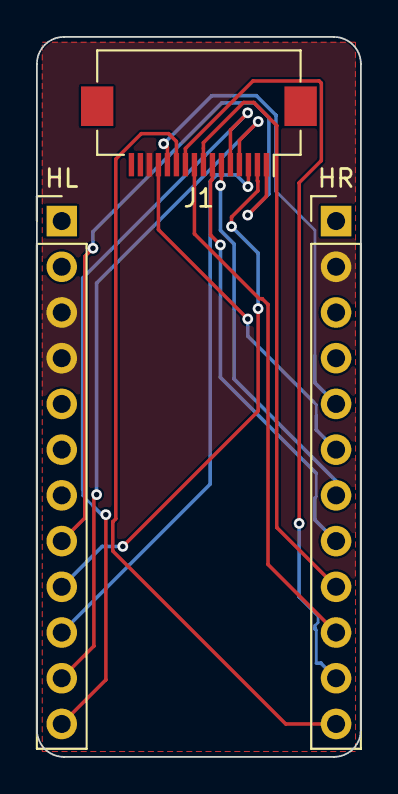
[picture p44: board adapter_a.kicad_pcb from above]

Board: 2 copper layers, 18.0 x 40.0 mm, 3 parts (0 on the bottom side), 14 nets.
