bhadkamkar9snehil/Sofpad/_to_delete/sofle_single_controller_orig/reference/Sofle_RGB/PCB/SofleKeyboard.kicad_pcb

## KiCad design _to_delete/sofle_single_controller_orig/reference/Sofle_RGB/PCB/SofleKeyboard.kicad_pcb (2026-11-09)

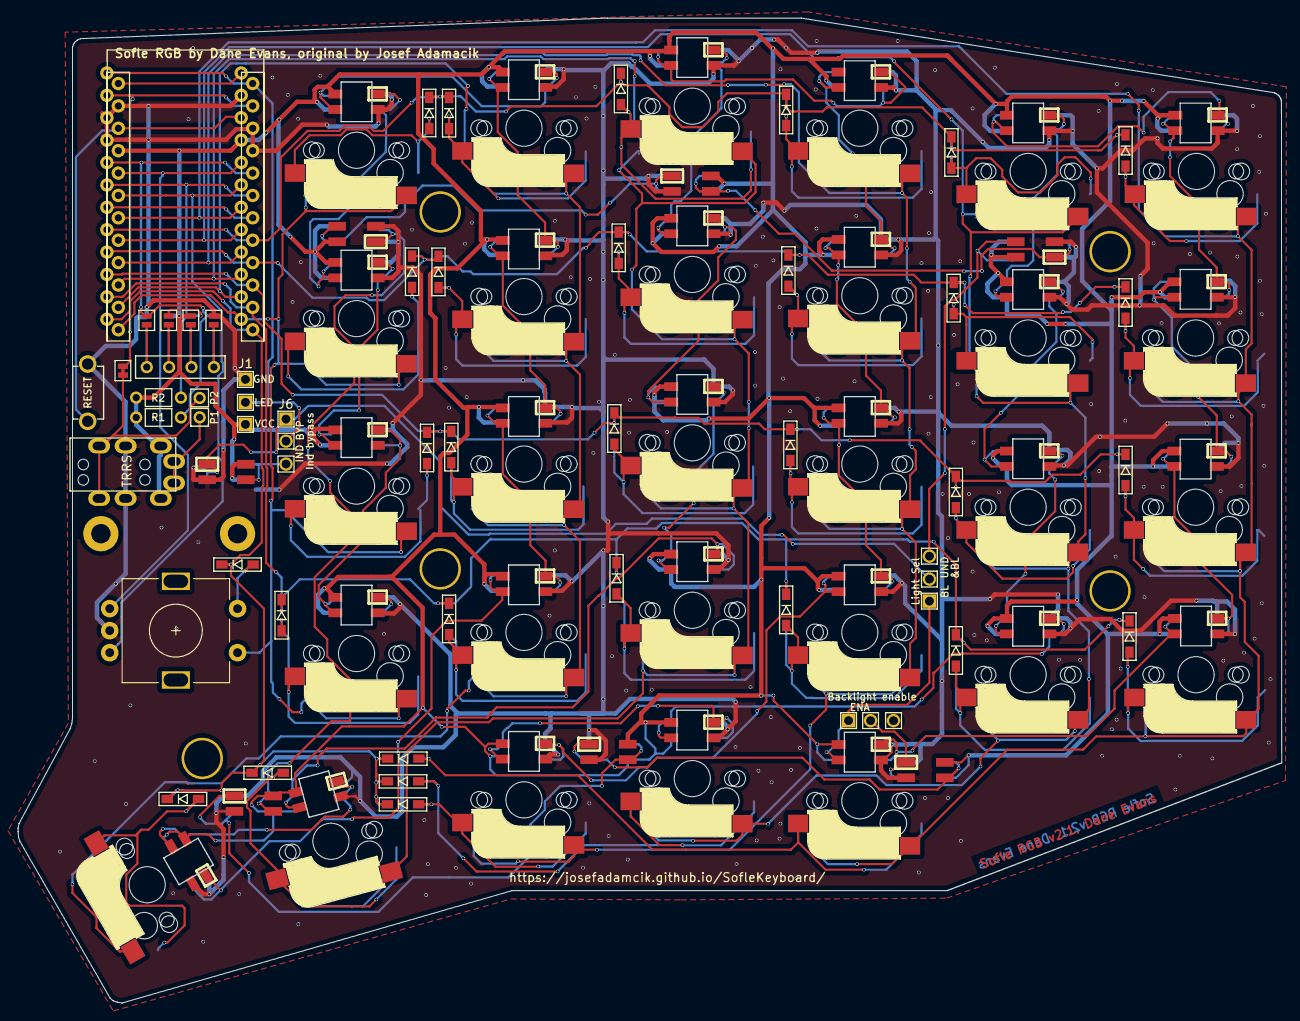
[picture p45: board SofleKeyboard.kicad_pcb from above]

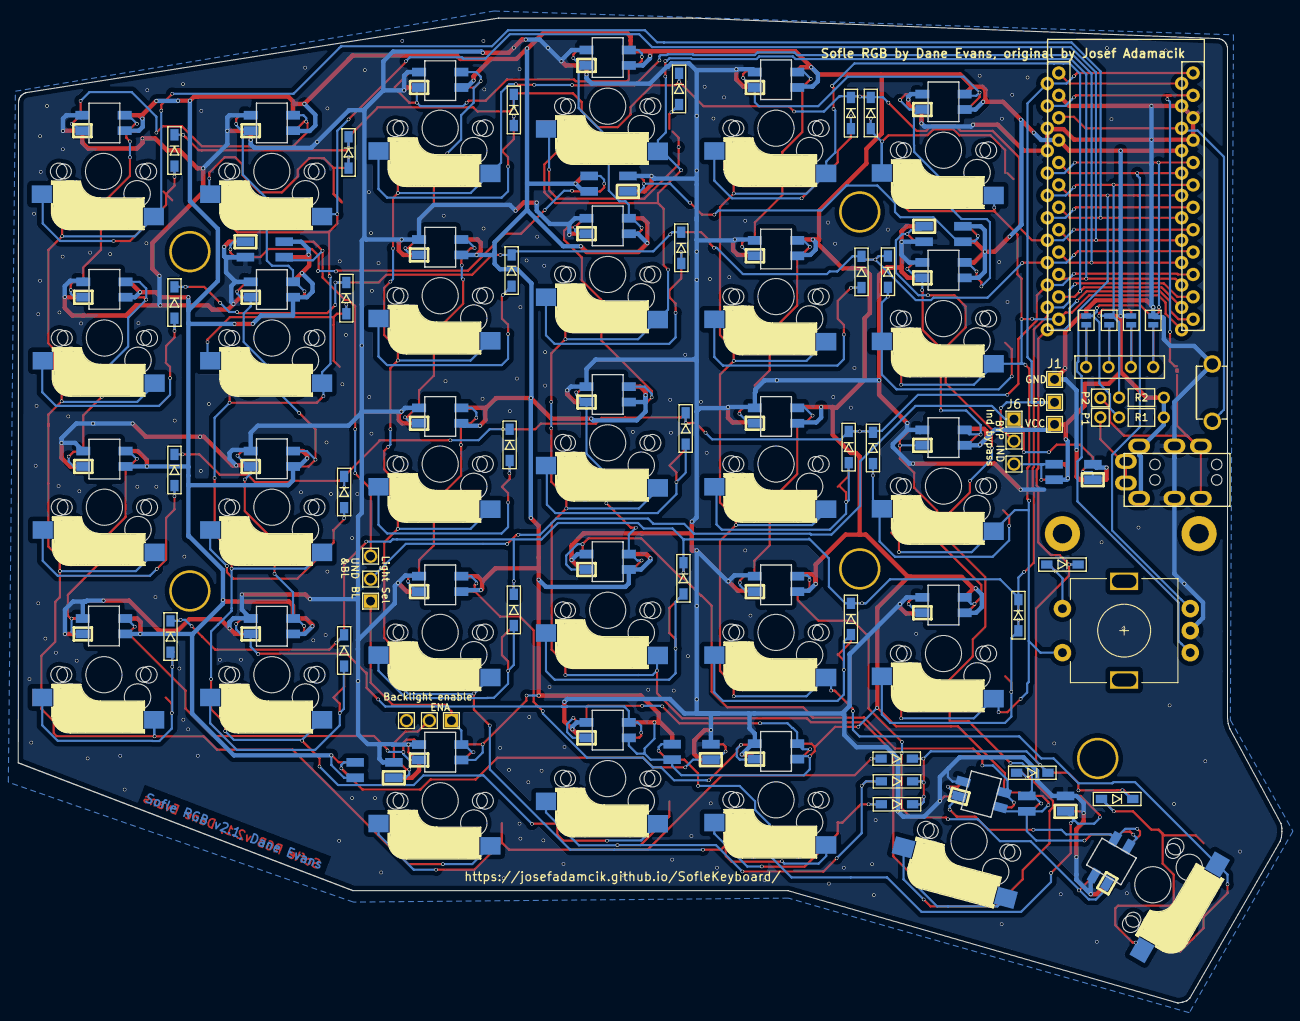
[picture p46: board SofleKeyboard.kicad_pcb from below]

Board: 2 copper layers, 143.4 x 111.8 mm, 95 parts (4 on the bottom side), 94 nets.

Parts:
D1, D2, D3, D4, D5, D6, D7, D8, D9, D10, D11, D12, D13, D14, D15, D16, D17, D18, D19, D20, D21, D22, D23, D24, D25, D26, D27, D28, D29, D30: D; crkbd-diode
D31, D32, D33, D34, D35, D36, D37: LED_sk2812_SM; SK6812MINI_underglow_dev
J1: LED
J2: 4PIN; MJ-4PP-9
J3: OLED; OLED_4Pin
J4: key leds; 3x1header
J5: backlight sel; 3x1header
J6: indicator bypass; 3x1header
JP1, JP2, JP3, JP4, JP5, JP6, JP7, JP8: Jumper_NO_Small; Jumper
P1, P2: i2c_pin; 1pin_conn
R1, R2: R; RESISTOR_mini
RSW1: SW_RST; TACT_SWITCH_TVBP06
SW1, SW2, SW3, SW4, SW5, SW6, SW7, SW8, SW9, SW10, SW11, SW12, SW13, SW14, SW15, SW16, SW17, SW18, SW19, SW20, SW21, SW22, SW23, SW24, SW26, SW27, SW28, SW29, SW30: SW_PUSH-MX_W_LED; SK6812MINI_and_cherry
SW25: Rotary_Encoder_Switch; RotaryEncoder_Alps_EC11E-Switch_Vertical_H20mm-keebio_modif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
TH1, TH2: HOLE; M2_HOLE_PCB
TH3, TH4, TH5, TH6, TH7: HOLE; HOLE_M2_TH
U1: ProMicro
W1: jumper; jumper_data

Connections:
/backlight: J4.1, J5.1, SW30.3
/i2c_c: J2.4, P1.1
/i2c_d: J2.3, P2.1, W1.2
/underglow: D33.3, J4.3
DATA: U1.2, W1.1
ENCA: SW25.A, U1.20
ENCB: SW25.B, U1.19
GND: D31.2, D32.2, D33.2, D34.2, D35.2, D36.2, D37.2, J1.3, J2.2, JP1.2, JP8.2, RSW1.1, SW1.2, SW2.2, SW3.2, SW4.2, SW5.2, SW6.2, SW7.2, SW8.2, SW9.2, SW10.2, SW11.2, SW12.2, SW13.2, SW14.2, SW15.2, SW16.2, SW17.2, SW18.2, SW19.2, SW20.2, SW21.2, SW22.2, SW23.2, SW24.2, SW25.C, SW26.2, SW27.2, SW28.2, SW29.2, SW30.2, U1.3, U1.4, U1.23
LED: J1.2, J6.2, U1.1
unnamed: D1.2, SW1.5
unnamed: D2.2, SW2.5
unnamed: D3.2, SW3.5
unnamed: D4.2, SW4.5
unnamed: D5.2, SW5.5
unnamed: D6.2, SW6.5
unnamed: D7.2, SW7.5
unnamed: D8.2, SW8.5
unnamed: D9.2, SW9.5
unnamed: D10.2, SW10.5
unnamed: D11.2, SW11.5
unnamed: D12.2, SW12.5
unnamed: D13.2, SW13.5
unnamed: D14.2, SW14.5
unnamed: D15.2, SW15.5
unnamed: D16.2, SW16.5
unnamed: D17.2, SW17.5
unnamed: D18.2, SW18.5
unnamed: D19.2, SW19.5
unnamed: D20.2, SW20.5
unnamed: D21.2, SW21.5
unnamed: D22.2, SW22.5
unnamed: D23.2, SW23.5
unnamed: D24.2, SW24.5
unnamed: D26.2, SW26.5
unnamed: D27.2, SW27.5
unnamed: D28.2, SW28.5
unnamed: D29.2, SW29.5
unnamed: D30.2, SW30.5
unnamed: D31.1, D34.3
unnamed: D31.3, D32.1
unnamed: D32.3, D33.1
unnamed: D34.1, D35.3
unnamed: D35.1, D36.3
unnamed: D36.1, J5.2
unnamed: D37.3, J6.3
unnamed: J3.1, JP4.1, JP8.1
unnamed: J3.2, JP3.1, JP7.1
unnamed: J3.3, JP2.1, JP6.1
unnamed: J3.4, JP1.1, JP5.1
unnamed: SW1.1, SW7.3
unnamed: SW1.3, SW2.1
unnamed: SW2.3, SW8.1
unnamed: SW3.1, SW9.3
unnamed: SW3.3, SW4.1
unnamed: SW5.3, SW6.1
unnamed: SW4.3, SW10.1
unnamed: SW10.3, SW16.1
unnamed: SW11.1, SW17.3
unnamed: SW5.1, SW11.3
unnamed: SW6.3, SW12.1
unnamed: SW12.3, SW18.1
unnamed: SW13.1, SW19.3
unnamed: SW7.1, SW13.3
unnamed: SW8.3, SW14.1
unnamed: SW14.3, SW20.1
unnamed: SW15.1, SW21.3
unnamed: SW9.1, SW15.3
unnamed: SW16.3, SW22.1
unnamed: SW17.1, SW23.3
unnamed: SW18.3, SW24.1
unnamed: SW20.3, SW26.1
unnamed: SW21.1, SW27.3
unnamed: SW22.3, SW28.1
unnamed: SW23.1, SW29.3
unnamed: SW24.3, SW30.1
unnamed: SW26.3, SW27.1
unnamed: SW28.3, SW29.1
RESET: RSW1.2, U1.22
SCL: JP3.2, JP6.2, R2.2, U1.6
SDA: JP4.2, JP5.2, R1.2, U1.5
SW25A: SW1.6, SW7.6, SW13.6, SW19.6, SW25.S1, U1.13
SW25B: D25.2, SW25.S2
VCC: D31.4, D32.4, D33.4, D34.4, D35.4, D36.4, D37.4, J1.1, J2.1, JP2.2, JP7.2, R1.1, R2.1, SW1.4, SW2.4, SW3.4, SW4.4, SW5.4, SW6.4, SW7.4, SW8.4, SW9.4, SW10.4, SW11.4, SW12.4, SW13.4, SW14.4, SW15.4, SW16.4, SW17.4, SW18.4, SW19.4, SW20.4, SW21.4, SW22.4, SW23.4, SW24.4, SW26.4, SW27.4, SW28.4, SW29.4, SW30.4, U1.21
col0: SW6.6, SW12.6, SW18.6, SW24.6, SW30.6, U1.18
col1: SW5.6, SW11.6, SW17.6, SW23.6, SW29.6, U1.17
col2: SW4.6, SW10.6, SW16.6, SW22.6, SW28.6, U1.16
col3: SW3.6, SW9.6, SW15.6, SW21.6, SW27.6, U1.15
col4: SW2.6, SW8.6, SW14.6, SW20.6, SW26.6, U1.14
lights: D37.1, J4.2, J6.1
row0: D1.1, D2.1, D3.1, D4.1, D5.1, D6.1, U1.8
row1: D7.1, D8.1, D9.1, D10.1, D11.1, D12.1, U1.9
row2: D13.1, D14.1, D15.1, D16.1, D17.1, D18.1, U1.10
row3: D19.1, D20.1, D21.1, D22.1, D23.1, D24.1, U1.11
row4: D25.1, D26.1, D27.1, D28.1, D29.1, D30.1, U1.12
