bhadkamkar9snehil/Sofpad/(commit log)

2026-11-09 Add original Sofpad R3 bill of materials
    [BOM.csv]
2026-11-09 Expand Sofpad README with architecture, diagrams, hardware, BOM and roadmap
2026-11-09 Uploading source files as individuals manually
    [BOM.csv, Cirque40_Retainer.stl, SofleKeyboard.kicad_pcb, SofleRGB_Couch_Case.scad, SofleRGB_Couch_Case.stl, SofleRGB_SingleController_Cirque.scad, SofleRGB_Unibody_Couch.scad, TPS43_Fit_Coupon.stl]
2026-11-09 Organize Sofpad into revisioned hardware and CAD folders, restore comprehensive README
    [BOM.csv, Cirque40_Retainer.stl, SofleKeyboard.kicad_pcb, SofleRGB_Couch_Case.scad, SofleRGB_Couch_Case.stl, SofleRGB_SingleController_Cirque.scad, SofleRGB_Unibody_Couch.scad, TPS43_Fit_Coupon.stl]
2026-11-09 Merge R3 (TPS43/I2C) update into repo layout
    Replace older R3 files in cad/r3 and hardware/r3, fill empty uploads, add ELECTRICAL_REVIEW.md, README_R3_INDEX.md, MIT LICENSE, tools/setup-windows.ps1. Superseded folders moved to _to_delete/.
    [BOM.csv, Cirque40_Retainer.stl, Service_Bottom.stl, SofleKeyboard.kicad_pcb, SofleRGB_Couch_Case.scad, SofleRGB_Couch_Case.stl, SofleRGB_SingleController_Cirque.scad, SofleRGB_Unibody_Couch.scad]
2026-11-09 R3: rectangular TPS43 pocket in CAD, BOM subtotal fixed
    [SofleRGB_SingleController_Cirque.scad]
2026-11-09 BOM: India-only sourcing, resolved TBD parts, charger resistors, print vendor
    [BOM.csv]
2026-11-09 CAD: re-render R3 STLs with TPS43 pocket, verify closed meshes
    [Cirque40_Retainer.stl, Service_Bottom.stl, TPS43_Retainer.stl, Unibody_Shell.stl]
2026-11-09 CAD: Alice-layout R3 case (WIP) and Blender render script
    [Sofpad_R3_Alice.scad, padface.stl, retainer.stl]
2026-11-09 CAD: Alice-layout R3 case with TPS65 pocket, closed meshes, new renders
    [Service_Bottom.stl, SofleRGB_SingleController_Cirque.scad, Sofpad_R3_Alice.scad, TPS43_Retainer.stl, Unibody_Shell.stl, battery.stl, bottom.stl, carrier.stl]
2026-11-09 Centre trackpad (TPS65), checks, README and renders in docs/images, design rules
    [BOM.csv, Sofpad_R3_Alice.scad, battery.stl, bottom.stl, carrier.stl, keys.stl, knobs.stl, padface.stl]
2026-11-09 Large centre screen, MX/DSA keys in CAD and renders, firmware plan, trimmed docs
    [BOM.csv, Sofpad_R3_Alice.scad, keys.stl, knobs.stl, padface.stl, screen.stl, shell.stl, switches.stl]
2026-11-09 CAD: pad glued under 1.0 mm skin, rear bay, low carrier; KiCad generators for carrier and adapter (ERC clean)
    [Sofpad_R3_Alice.scad, adapter.kicad_sch, bottom.stl, carrier.kicad_sch, retainer.stl, shell.stl]
2026-11-09 README: low-power and driver notes from keyboard research
2026-11-09 Power and sleep/wake design: System ON idle, per-part wake paths, acceptance tests
2026-11-09 BOM: exact passives, connectors matched to PCB footprints, no paint, optional PC app; CAD carrier on foam pads
    [BOM.csv, Sofpad_R3_Alice.scad, bottom.stl, carrier.dsn, carrier.kicad_pcb]
2026-11-09 PCB: adapter boards A/B routed, carrier layout and netlist (encoder pull-ups), full-scene Blender script, adapters in CAD checks
    [Sofpad_R3_Alice.scad, adapter_a.dsn, adapter_a.kicad_pcb, adapter_b.dsn, adapter_b.kicad_pcb, adapter_conns.stl, adapters.stl, battery.stl]
2026-11-09 CAD: groove outlines the trackpad area on the top face
    [Sofpad_R3_Alice.scad, bottom.stl, retainer.stl, shell.stl]
2026-11-09 CAD: service labels and cable hooks on the plate; fab export script; faster router settings
    [Sofpad_R3_Alice.scad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]
2026-11-10 r3: BOM connector and R13-R16 updates, manufacturing section, new design rules, carrier keepout ring
    [BOM.csv, carrier.dsn, carrier.kicad_pcb, carrier.kicad_sch]
2026-11-10 r3: no-hardware verification suite (netlist cross-check, signal paths, power checks, pin audit, placement gate), GND fanout, postfix
    [adapter_a-B_Courtyard.gbr, adapter_a-B_Cu.gbl, adapter_a-B_Fab.gbr, adapter_a-B_Mask.gbs, adapter_a-B_Paste.gbp, adapter_a-B_Silkscreen.gbo, adapter_a-Edge_Cuts.gm1, adapter_a-F_Courtyard.gbr]
2026-11-10 r3: carrier routed (DRC 0 errors, 0 unconnected), fab files for carrier and adapters, new renders with the real carrier, README status
    [carrier-B_Courtyard.gbr, carrier-B_Cu.gbl, carrier-B_Fab.gbr, carrier-B_Mask.gbs, carrier-B_Paste.gbp, carrier-B_Silkscreen.gbo, carrier-Edge_Cuts.gm1, carrier-F_Courtyard.gbr]
